Tanay7/Benchmarks/docs/13_Web_UI_Reference.md

# 13 - Ground Station Web UI Reference

This is the operator's reference for the DSS-Q1 web dashboard: the page the ground data
system (GDS) serves on the Arduino VENTUNO Q for the VGQ-1 mission. It explains every tab,
every panel and every number on it: what the number means, which snapshot key carries it,
where it comes from (a radio reading, a telemetry field, a counter or a formula), how often
it changes, what values to expect from this hardware, and what to do when a value looks
wrong.

How to use this document:

* New to the dashboard: read [section 1](#1-how-the-dashboard-works) (where the numbers come
  from, the badges, the number formats and the statistics), then
  [section 2](#2-header-bar-and-beacon-banner) (the header bar), then the tab you need.
* Running a range test: follow [section 17](#17-reading-the-receiver-tab-during-a-range-test).
* Something is red or yellow: [section 15](#15-alarm-logic) lists every alarm reason, and
  [14_Troubleshooting_and_Event_Response.md](14_Troubleshooting_and_Event_Response.md) gives
  the cause and the operator response for every event and alarm.
* Connecting a monitoring system: [section 16](#16-machine-interfaces-metrics-and-the-json-api).

Related documents: [02_Link_Budget_and_RF_Analysis.md](02_Link_Budget_and_RF_Analysis.md)
(sensitivities, link budgets, range), [04_Space_Data_Link_ICD.md](04_Space_Data_Link_ICD.md)
(frames, packets, SDLS, COP-1, CFDP), [05_Telemetry_and_Command_Dictionary.md](05_Telemetry_and_Command_Dictionary.md)
(every packet field and command, generated from the dictionary),
[06_Displays.md](06_Displays.md) (station lamps, buzzer, CardKB console, spacecraft LED
matrix), [07_Operations_Procedures.md](07_Operations_Procedures.md),
[08_Verification_and_Test.md](08_Verification_and_Test.md) (the T-RF-xx tests named below),
[15_Configuration_Reference.md](15_Configuration_Reference.md) (every `station.toml` key),
[17_Security_Model.md](17_Security_Model.md), [18_Data_Products.md](18_Data_Products.md)
(archive, `rx_stats`, CSV export, TDM, XTCE), [19_Glossary.md](19_Glossary.md).

**Where the facts come from.** Every key, formula, threshold and label below was checked
against the final code:
[gds.py](../dssq-groundstation/python/dssq/gds.py) (`GroundStation.snapshot()`,
`science_snapshot()`, `panel_status()`, `_compute_alarm()`),
[rxstats.py](../dssq-groundstation/python/dssq/rxstats.py),
[link.py](../dssq-groundstation/python/dssq/link.py),
[linkmgr.py](../dssq-groundstation/python/dssq/linkmgr.py),
[datalog.py](../dssq-groundstation/python/dssq/datalog.py),
[export.py](../dssq-groundstation/python/dssq/export.py),
[web.py](../dssq-groundstation/python/dssq/display/web.py),
[dashboard.html](../dssq-groundstation/python/dssq/display/dashboard.html),
[dictionary.py](../dssq-groundstation/python/dssq/dictionary.py),
[spectral.py](../dssq-groundstation/python/dssq/spectral.py) and
[magcal.py](../dssq-groundstation/python/dssq/magcal.py), plus the flight packet builder
[flight.cpp](../vgq1-spacecraft/sketch/src/fsw/flight.cpp) for the meaning of telemetry
fields. Where an older document disagrees with the code, the code wins.

**About the example values.** Unless a section says otherwise, the example numbers were
produced by the GDS running against its built-in software spacecraft
(`python -m dssq.gds --sim`, and the same `GroundStation` with the simulator on a virtual
clock): an E22-400T33D link at air-rate code 2 (2.4 kbit/s) and an SX126x link at LoRa
profile 1 (SF12, 62.5 kHz), with a configured distance of 2 km. They show how the numbers
relate to each other; they are not hardware measurements, and a rerun gives somewhat
different numbers (the simulated channel fades and loses frames at random). Where a later
code change altered a value (station identification, RF `tx_duty`, `last_airtime`,
`cltu_bad`), the text says so and quotes a rerun with the final code. The simulator's RF channel is
synthetic: the RSSI hovers around -112 dBm (E22) or -125 dBm (SX126x) and the noise floor
around -118 dBm whatever distance is configured, which is why its "excess loss" comes out
near 67 dB. On real hardware every value marked "VERIFY on hardware" still needs the test
named in [08_Verification_and_Test.md](08_Verification_and_Test.md).

**Screenshots** in [img/](img/) were taken from the simulator (E22 at air-rate code 7,
62.5 kbit/s, with a demonstration command load). A few panels showed paths of the test
machine; those were replaced with neutral placeholders such as `<archive>/files`.

**Drift protection.** [tests/test_docs.py](../tests/test_docs.py) builds real snapshots
(GDS plus simulator, E22 and SX126x) and fails when a snapshot key is missing from this
document, or when a key path written here does not exist in the snapshot.

## Contents

1. [How the dashboard works](#1-how-the-dashboard-works)
2. [Header bar and beacon banner](#2-header-bar-and-beacon-banner)
3. [OVERVIEW tab](#3-overview-tab)
4. [RECEIVER tab](#4-receiver-tab)
5. [LINK & SECURITY tab](#5-link--security-tab)
6. [FRAMES & PACKETS tab](#6-frames--packets-tab)
7. [SPACECRAFT tab](#7-spacecraft-tab)
8. [SPECTROMETER tab](#8-spectrometer-tab)
9. [SCIENCE tab](#9-science-tab)
10. [MAGCAL tab](#10-magcal-tab)
11. [SEQUENCES tab](#11-sequences-tab)
12. [FILES tab](#12-files-tab)
13. [COMMANDING tab](#13-commanding-tab)
14. [Health, events and logs](#14-health-events-and-logs)
15. [Alarm logic](#15-alarm-logic)
16. [Machine interfaces: /metrics and the JSON API](#16-machine-interfaces-metrics-and-the-json-api)
17. [Reading the RECEIVER tab during a range test](#17-reading-the-receiver-tab-during-a-range-test)
18. [Snapshot key index](#18-snapshot-key-index)

---

## 1 How the dashboard works

### 1.1 The path of a number

In plain words: the station radio hands every received packet to the GDS, together with its
signal strength (and, for the SX126x, its signal-to-noise ratio and frequency error). The
GDS finds the frame in it, repairs bit errors with the Reed-Solomon code, checks the frame,
opens the encryption, takes the telemetry packets out, decodes them into named values and
updates its statistics. All of that lives in one state object inside the GDS. Once a second
the web page asks for a copy of that state (the **snapshot**) and redraws the tab you are
looking at. The page never computes link quantities itself: it formats what the GDS sends.

```mermaid
flowchart LR
  RAD["Station radio<br/>E22 (UART) or SX126x (SPI)"] -->|"octets + RSSI octet, or<br/>packet + RSSI / SNR / freq. error"| RUN["GDS radio thread<br/>dssq.gds.Runner"]
  RUN --> DEC["frame sync, RS(255,223),<br/>FECF, SDLS, packets, decom"]
  DEC --> RXS["receiver statistics<br/>rxstats.ReceiverStats"]
  DEC --> TLM["telemetry, limits, events,<br/>COP-1, CFDP, TDM"]
  RXS --> SNAP["GroundStation.snapshot()"]
  TLM --> SNAP
  SNAP -->|"GET /api/state (1 Hz)"| PAGE["dashboard.html"]
  SNAP -->|"GET /metrics"| PROM["Prometheus scraper"]
  SPEC["SpectralState"] -->|"GET /api/science"| PAGE
  SNAP -->|"1 Hz rx_stats row"| ARC["archive gds.sqlite"]
```

The GDS main loop (`Runner.step()` in [gds.py](../dssq-groundstation/python/dssq/gds.py))
runs ten stages in order: register, radio_read, ingest, packets, outbox, jobs, afc, tdm,
housekeeping, console. Each stage is an error boundary: an unexpected failure is counted in
`health.stage_errors`, logged at most once a minute and the loop carries on
([section 14](#14-health-events-and-logs)).

Every number is one of four kinds, and the page says which:

| Kind | Meaning | Example |
|---|---|---|
| measured | read from the radio, the decoder, a counter or a telemetry field | packet RSSI, RS symbols corrected, HK `bus_temp` |
| derived ("est.") | computed from measurements with a stated assumption | SNR est. = RSSI - noise, link margin est., C/N0 est. |
| computed / datasheet / estimated | from a formula or a datasheet, no measurement | free-space path loss, receiver sensitivity |
| configured | typed into `station.toml` | antenna gains, line losses, distance |

A value the GDS does not have is sent as JSON `null` and shown as **—**. Nothing is ever
invented to fill a gap.

### 1.2 Opening the dashboard

| Item | Fact | Source |
|---|---|---|
| URL | `http://<board address>:8080/` | [app.yaml](../dssq-groundstation/app.yaml) `ports: [8080]`; host mode: `[gds] http_host` / `http_port` |
| Bind address | the App's rules (App Lab, and host mode with `python -m dssq.gds --app-data <App>/data`): all interfaces (`0.0.0.0`, override with `DSSQ_HTTP_HOST`); a stand-alone `--config` file: `[gds] http_host` (default `127.0.0.1`) | `resolve_app_paths()` in [config.py](../dssq-groundstation/python/dssq/config.py), `station.toml` |
| Reading | anyone who can reach the port can read every tab | [web.py](../dssq-groundstation/python/dssq/display/web.py) |
| Commanding | every POST needs the `X-DSSQ-Token` header equal to `[gds] http_token`; with the App's rules an empty token is read from, or created once in, `<App>/data/http_token` (mode 0600). A LAN-bound server without a token refuses every POST: the page is read-only | web.py `_check_token` |
| Token entry | the **TOKEN** button in the header (or the prompt after the first refused POST) keeps the token for this browser session only (`sessionStorage`); "TOKEN ✓" means one is set | dashboard.html `setToken` |
| Second operator | with `[commanding] require_two_person_for_hazardous = true`, a hazardous command also needs **2nd-OP AUTH**; with `[commanding] auth_token` set, AUTH also needs the `X-DSSQ-Auth` secret (asked every time, never stored) | gds.py `confirm`, web.py `_check_auth` |
| DNS names | a LAN server answers only IP literals, single-label names, `<name>.local` and `[gds] http_allowed_hosts` (DNS-rebinding guard) | web.py `host_allowed` |

Security details (CSP, request limits, CSRF and DNS-rebinding defences) are in
[17_Security_Model.md](17_Security_Model.md).

### 1.3 How often things change

**What the page polls** (dashboard.html):

| Request | When | Used by |
|---|---|---|
| `GET /api/state` | every 1 s (the next poll starts 1 s after the previous answer; one request at a time) | every tab and the header |
| `GET /api/science` | every 1 s while SPECTROMETER or SCIENCE is visible, every 10 s otherwise | SPECTROMETER, SCIENCE (boom radii) |
| `GET /api/files`, `/api/tdm`, `/api/exports` | when the FILES tab is shown and the lists are older than 5 s | FILES |
| `GET /api/dictionary` | once at start (retried every 5 s until it loads) | enumeration names, command help, builders |

The header shows "GDS LINK DOWN (n s)" in red when no `/api/state` answer arrived for more
than 5 s.

**What drives each value** (the source, not the page):

| Driver | Values | Rate |
|---|---|---|
| every received radio unit (E22 CADU, SX126x packet, also ones that fail to decode) | packet RSSI, SX126x SNR and frequency error, histograms, CRC counters | once per frame period |
| every frame that passes RS and the frame check (FECF) | frame counters, FER, inter-arrival time, the 300-frame chart series | once per frame period |
| a noise-floor reading | noise floor, SNR est. | at most once per `[radio] noise_poll_s` (default 20 s), requested after a received frame when no command is waiting to go up |
| GDS housekeeping | LOS detection, alarm, data-logger row, AFC timers | 1 Hz |
| link manager | its recommendation | every `[linkmgr] period_s` (default 60 s) |
| spacecraft telemetry packets | everything decoded from HK, RF, MAG, ... | the flight cadence below |

The spacecraft sends one frame per **frame period**. The flight software sets it
(`frame_period_ms()` in [datalink.cpp](../vgq1-spacecraft/sketch/src/fsw/datalink.cpp)) to
the largest of: busy time x mode factor (BOOT and SAFE 4.0, CRUISE 2.5, ENCOUNTER and TEST
2.0), busy time / 0.5 (the 50 % transmitter duty limit), 1.5 s, and the FPERIOD command
value; it doubles while the PA over-temperature flag is set. The busy time per frame is
UART transfer plus estimated air time for the E22 and the exact LoRa air time for the
SX126x (`link.busy_s()`):

| Radio and rate | Busy time per frame | Frame period SAFE / CRUISE / ENCOUNTER, TEST |
|---|---|---|
| E22 code 0-2 (2.4 kbit/s) | 1.267 s (245 ms UART + 1022 ms air) | 5.07 / 3.17 / 2.53 s |
| E22 code 3 (4.8 kbit/s) | 0.756 s | 3.02 / 1.89 / 1.51 s |
| E22 code 4 (9.6 kbit/s) | 0.500 s | 2.00 / 1.50 / 1.50 s |
| E22 code 5-7 (19.2-62.5 kbit/s) | 0.372 / 0.308 / 0.284 s | 1.50 s (floor) |
| SX126x profile 0 (SF12, 31.25 kHz) | 34.636 s | 138.5 / 86.6 / 69.3 s |
| SX126x profile 1 (SF12, 62.5 kHz) | 17.318 s | 69.3 / 43.3 / 34.6 s |
| SX126x profile 2 (SF12, 125 kHz) | 8.659 s | 34.6 / 21.6 / 17.3 s |
| SX126x profile 3 (SF11, 125 kHz) | 4.740 s | 19.0 / 11.9 / 9.5 s |
| SX126x profile 4 (SF10, 125 kHz) | 2.165 s | 8.7 / 5.4 / 4.3 s |
| SX126x profile 5 (SF9, 125 kHz) | 1.185 s | 4.7 / 3.0 / 2.4 s |
| SX126x profile 6 (SF8, 125 kHz) | 0.665 s | 2.7 / 1.7 / 1.5 s |
| SX126x profile 7 (SF7, 125 kHz) | 0.373 s | 1.5 s (floor) |

Telemetry packets are generated at the flight's per-mode cadence (`kModeCadence`, seconds,
0 = off) and stretched on board when the link cannot carry them; `PKTRATE` overrides one
packet type:

| Mode | HK | RF | TIMECORR | MAG | ATT | SPEC | ENV |
|---|---|---|---|---|---|---|---|
| BOOT | 10 | 10 | off | off | off | off | off |
| SAFE | 30 | 60 | 300 | off | off | off | off |
| CRUISE | 60 | 60 | 300 | 30 | 60 | 300 | 120 |
| ENCOUNTER | 20 | 30 | 120 | 4 | 8 | 30 | 30 |
| TEST | 10 | 10 | 60 | 4 | 8 | 30 | 30 |

So a value decoded from HK changes at most every 10-60 s, while the RECEIVER values move
with every frame.

### 1.4 Measured, estimated, computed: the badges and labels

Small coloured badges and words in labels tell you how far to trust a number.

| Badge or label | Colour | Meaning | Where it appears |
|---|---|---|---|
| **measured** | green | read from a radio, decoder or counter; for a sensitivity: a value from test T-RF-03 in `[radio.sensitivity_measured]` | link budget "measured" column; sensitivity source |
| **datasheet** | blue | taken from a manufacturer datasheet | sensitivity (T33D -128 dBm, T37S -126 dBm at 2.4 kbit/s; SX126x where Semtech Table 3-8 lists the profile); T37S TX power (37 dBm on every code) |
| **computed** | blue in the link budget, amber as a sensitivity source | a formula on configured or datasheet inputs, no measurement: free-space loss, thermal noise, the SX126x sensitivity -174 + 10 log10(BW) + NF + SNRmin | link budget, sensitivity source, LoRa air time |
| **estimated** | amber | an extrapolation from a datasheet value: E22 sensitivity above 2.4 kbit/s, E22 air time, SX126x sensitivity without boosted gain | sensitivity source, air-time source |
| **configured** | grey | typed into `station.toml` | antenna gains, line losses, distance |
| **est.** | amber | a derived quantity resting on an assumption | EIRP, excess loss, link margin, range at sensitivity, SNR est. |
| **VERIFY T-RF-07** | amber | the transmitter power for this code has not been measured yet (E22-400T33D codes 1-3 and every SX126x code; the T37S is "datasheet") | link budget, radio configuration |
| "est." in a label | - | the same as the badge: "SNR est. (RSSI - noise)", "N0 est." | RECEIVER |
| "approximate (18-band)" | - | spectrometer radiometry and colorimetry built from 18 filter bands | SPECTROMETER |
| "heuristic" | - | rule-based judgement (light-source class, fluorescence, burst transients) | SPECTROMETER |
| "proxy" | - | an index evaluated on the nearest available bands (WBI, PRI) | SPECTROMETER |
| "informational" | - | shown for insight, not for decisions (die-temperature drift) | SPECTROMETER |
| **MISMATCH** | red | the spacecraft reports a different radio model, or the station SX126x sketch was built for another chip / TCXO | RECEIVER radio configuration, SX126x MCU |

Telemetry limits colour the value cell: yellow background for YELLOW, red for RED
([section 7.2](#72-limits-and-how-they-are-checked)). Text colours: green = good, amber =
needs attention, red = bad, grey = not applicable.

### 1.5 Display conventions

The page formats numbers with a few helpers in dashboard.html; the table says which one
each kind of value uses.

| Kind of value | Shown as | Example | Rule (dashboard.html) |
|---|---|---|---|
| measured received power and what is derived from it (RSSI, noise floor, SNR est., margin est., signal power est., N0, C/N0, Eb/N0, measured path loss): single readings and window statistics alike | at the readings' resolution, never finer (D-70): whole dB with the E22; with the SX126x RSSI in 0.5 dB steps, the rest in 0.1 dB; means are shown without "± SEM" | -39 dBm (E22), -113.5 dBm (SX126x) | `fres(v, kind)` |
| SX126x measured SNR (SnrPkt/4) | 2 decimals (0.25 dB steps) | 6.25 dB | `fx(v, 2)` |
| computed link-budget figures (the "design" column) | 4 decimals | -110.4321 dBm | `fx(v, 4)` |
| frequencies, frequency errors, Doppler | 1 decimal, Hz | 433125000.0 Hz, 469.0 Hz | `fu(v, 1, "Hz")` |
| frequency in MHz | 6 decimals | 433.125000 MHz | RF now |
| range rate | 3 decimals, m/s | -1161.447 m/s | Doppler panel |
| rates and percentages | 2 decimals | 22.00 bit/s, 79.94 % | `fpct()`, `fx(v, 2)` |
| FER, BER, SER, CER, packet error rate | scientific, 3 significant digits | 4.18e-2 | `fsci()` = `toExponential(2)` |
| spectral values (µW/cm²) | 4 significant digits | 40.07 | `fsig(v, 4)` |
| counts | whole numbers with thousands separators | 81,803 | `fint()` |
| telemetry fields (SPACECRAFT) | the decimals of the field's scale (0.01 -> 2, 0.1 -> 1, 0.001 -> 3); integers as integers | 32.42 degC | `tlmTable()` |
| times | UTC, ISO 8601 to the second | 2027-01-15T08:00:02Z | `iso()` |
| times in logs | time of day, UTC | 20:52:19Z | `tod()` |
| durations | seconds below 1 min, else d h m s | 5.4 s, 20m 28s | `dur()` |
| "ago" | time since the value's timestamp | 1m 9s ago | `ago()` |
| file sizes (CFDP, TDM, exports) | binary units | 4.2 KiB | `size()` |
| archive sizes (data logger) | SI units, as `archive_max_gb` / `archive_min_free_mb` | 13.2 GB | `sizeSI()` |
| one-way light time | µs, ms or s with 3 decimals | 6.671 µs | `owlt()` |
| booleans | yes / no | yes | `fyn()` |
| no value | — | — | null, missing, NaN or infinite |

**Resolution of a single reading** (what one reading can resolve, not its accuracy):

| Reading | Resolution | Source |
|---|---|---|
| E22 packet RSSI and noise register | 1 dB | E22-400T33D manual v1.05 REG1 bit 5 (registers 0x00 noise, 0x01 last packet) and REG3 bit 7 (the appended RSSI octet): one whole octet, dBm = -(256 - octet); the manual states no finer step and no accuracy (V-18). The SX1262's own 0.5 dB register is not passed through. `rxstats.E22_RSSI_RESOLUTION_DB` |
| SX126x packet RSSI | 0.5 dB | SX1261/2 datasheet GetPacketStatus: RssiPkt / 2; `rxstats.SX126X_RSSI_RESOLUTION_DB` |
| SX126x packet SNR | 0.25 dB | SnrPkt / 4 |
| SX126x noise floor | 0.1 dB | median of 8 instantaneous RSSI samples, sent in 0.1 dBm (`rf_noise`) |
| SX126x frequency error | 1 Hz (whole Hz from the station MCU) | `rf_rx` freq_err_hz |

The absolute accuracy of every RSSI and noise value is set by the station calibration
`[radio] rssi_cal_offset_db`, which test T-RF-02 determines
([08_Verification_and_Test.md](08_Verification_and_Test.md)). Until that test is done,
treat absolute dBm values as uncalibrated (VERIFY on hardware); differences between two
readings of the same radio are still meaningful.

### 1.6 The statistics windows explained

The RECEIVER tab keeps eight measured quantities in three windows and summarises each
window with eleven statistics (`rx.windows`, computed by `rxstats.Window.stats()`).

**The windows.**

| Window | Key | What it holds | Cap |
|---|---|---|---|
| 1 min | `rx.windows.1m` | samples of the last 60 s | 20,000 samples |
| 10 min | `rx.windows.10m` | samples of the last 600 s | 20,000 samples |
| pass | `rx.windows.pass` | samples since the current pass began (AOS); emptied at every AOS except for the AOS frame's own samples | 20,000 samples; then the oldest are dropped and the window reports `truncated` = true ("pass (truncated)") |

Old samples leave the 1 min and 10 min windows when a new sample arrives and whenever the
snapshot is built, so a window empties itself during LOS. The inter-pass gap is never
counted as an inter-arrival time.

**The statistics** (n samples x1 ... xn, sorted s1 <= ... <= sn):

| Column | Key | Formula | What it tells you |
|---|---|---|---|
| n | `n` | number of samples | how much the other columns are worth; with n = 1 there is no spread |
| mean | `mean` | (1/n) Σ xi | the typical level |
| ± SEM | `sem` | s / √n, with s = √(Σ (xi - mean)² / (n - 1)) the sample standard deviation | how well the mean is known (needs n >= 2) |
| σ | `std` | √(Σ (xi - mean)² / n), the population standard deviation | how much single readings scatter (fading, noise) |
| min | `min` | s1 | the worst (lowest) reading |
| p10 | `p10` | the 10th percentile, linear interpolation at k = 0.10 (n - 1) between neighbouring sorted samples | the level the signal stayed above 90 % of the time |
| p50 | `p50` | the median, k = 0.50 (n - 1) | the middle reading, robust to outliers |
| p90 | `p90` | the 90th percentile, k = 0.90 (n - 1) | the level exceeded only 10 % of the time |
| max | `max` | sn | the best (highest) reading |
| last | `last` | xn in arrival order | the newest reading |
| fade p90-p10 | `fade_depth` | p90 - p10 | the depth of fading: how far the signal swings |

**Worked example.** Five RSSI readings -112, -110, -113, -111, -114 dBm (computed with the
GDS's own `Window` class): n = 5, mean = -112.0000; deviations 0, +2, -1, +1, -2, so
Σ d² = 10; σ = √(10/5) = 1.4142 dB; s = √(10/4) = 1.5811 dB; SEM = 1.5811 / √5 = 0.7071 dB;
sorted -114, -113, -112, -111, -110: p10 at k = 0.4 gives -114 + 0.4 x 1 = -113.6000,
p50 = -112.0000, p90 at k = 3.6 gives -111 + 0.6 x 1 = -110.4000; fade depth = 3.2000 dB;
last = -114.0000.

**Why the readings' resolution?** (D-70, on the owner's request after the first bench link.)
The E22 reports received power and its noise register in whole dB, so the page shows no
digit finer than that: a 1-minute mean of -39.2 dBm is shown as -39 dBm, and its SEM, below the
resolution, is not shown at all. The statistics are still computed at full precision: the
snapshot (`rx.windows`), the RECEIVER statistics' source data, the CSV exports and the data
logger keep every digit, for anyone who wants to compare window means more finely. The
absolute accuracy is a separate matter again: it is limited by the calibration offset
(T-RF-02), not by the resolution. The worked example above shows the full-precision values;
the page shows them as -112, 1, 2, 1, -114, -114, -112, -110, -110, 3 and -114 dB(m).

**How to read SEM.** Two means differ significantly when their difference is larger than
about 2√(SEM1² + SEM2²). SEM assumes independent readings; slow fading makes neighbouring
frames correlated, so treat SEM as a lower bound on the uncertainty of the mean. Look at σ
and the fade depth to see how much single readings move.

### 1.7 Snapshot keys and the notation in this document

`/api/state` returns one JSON object (`GroundStation.snapshot()`, schema 3) with 37
top-level keys; `/api/science` returns the spectrometer analytics separately
(`science_snapshot()`). This document writes a value's location as a dotted path from the
root: `rx.rf.rssi_dbm` is `snapshot["rx"]["rf"]["rssi_dbm"]`. Paths that start with
`spectral`, `spectral_history`, `spectral_burst`, `spectral_skymap`, `spectral_library`,
`cfg` or `led_limits` are in `/api/science`. A part in angle brackets is a placeholder for a
name that varies: `vc.<vc>.frames` (one entry per virtual channel), `apids.<packet>.count`,
`tlm.<packet>.values.<field>`, `rx.windows.<window>.<metric>.<stat>`. `[]` after a part
means "each element of this list": `cfdp.transactions[].progress`.

| Top-level key | What it holds | Section |
|---|---|---|
| `schema` | snapshot schema version (3) | [13.7](#137-gds-health-panel) |
| `version` | GDS software version (`dssq.__version__`, 3.0.0) | [13.7](#137-gds-health-panel) |
| `utc` | station time when the snapshot was built (UNIX s) | [2](#2-header-bar-and-beacon-banner) |
| `station` | station name, `[station] name` | [2](#2-header-bar-and-beacon-banner) |
| `spacecraft` | spacecraft name, `[spacecraft] name` | [2](#2-header-bar-and-beacon-banner) |
| `uptime_s` | seconds since the GDS started | [13.7](#137-gds-health-panel) |
| `mode` | GDS run mode: `host`, `applab` or `sim` | [2](#2-header-bar-and-beacon-banner) |
| `alarm` | NONE, YELLOW or RED | [15](#15-alarm-logic) |
| `alarm_reasons` | every reason, RED first | [15](#15-alarm-logic) |
| `alarm_red_count` | how many of `alarm_reasons` are RED | [15](#15-alarm-logic) |
| `beacon` | spacecraft beacon level and history | [2](#2-header-bar-and-beacon-banner), [7.7](#77-beacon) |
| `rx` | receiver statistics engine (RF, windows, budget, decoder, frames ...) | [4](#4-receiver-tab) |
| `radio` | station radio configuration, model checks, jobs | [4.6](#46-radio-configuration) |
| `link` | framing, SDLS, OID identification, station identification | [5](#5-link--security-tab) |
| `sync` | frame synchronizer state and counters | [4.9](#49-frame-synchronizer) |
| `vc` | per-virtual-channel counters | [6.2](#62-virtual-channels) |
| `apids` | per-APID packet statistics | [6.3](#63-packets-by-apid) |
| `tlm` | latest decoded real-time packet of each type | [7](#7-spacecraft-tab), [9](#9-science-tab) |
| `decoded` | enumerations and bit masks of HK / RF / MAG as names | [7](#7-spacecraft-tab) |
| `time` | SCLK correlation | [5.8](#58-time-correlation) |
| `cop` | COP-1 FOP-1 sender state and recent commands | [5.5](#55-cop-1-fop) |
| `cfdp` | CFDP class-1 receiver and onboard sender state | [12.1](#121-cfdp-transactions) |
| `tdm` | CCSDS Tracking Data Message recorder | [12.4](#124-tracking-data-messages-and-xtce) |
| `sequence` | stored-sequence state, checked file, uplink | [11](#11-sequences-tab) |
| `magcal` | magnetometer calibration collectors and fits | [10](#10-magcal-tab) |
| `health` | GDS stage errors, archive write errors | [14](#14-health-events-and-logs) |
| `logger` | receiver data logger: rows, space, retention | [12.5](#125-receiver-data-logger) |
| `linkmgr` | adaptive link manager | [4.16](#416-link-manager-and-pass-events) |
| `pending_confirm` | commands waiting for CONFIRM / AUTH | [13.2](#132-pending-confirmations) |
| `evrs` | the last 40 spacecraft event reports | [7.10](#710-spacecraft-evrs) |
| `events` | the last 80 ground events | [14](#14-health-events-and-logs) |
| `anomalies` | the last 20 statistical outliers | [7.11](#711-anomaly-detector) |
| `console` | the last 30 console lines | [13.4](#134-console) |
| `station_io` | station I/O MCU (CardKB, annunciators) | [13.8](#138-station-io-panel) |
| `cmd_stages` | names of the CMDVER stages (for the page) | [7.9](#79-other-packets-cmdver-timecorr-rfscan) |
| `cmd_errors` | names of the command error codes | [7.9](#79-other-packets-cmdver-timecorr-rfscan) |
| `cmd_sources` | names of the CMDVER command sources | [7.9](#79-other-packets-cmdver-timecorr-rfscan) |

`/api/science` top-level keys: `spectral`, `spectral_history`, `spectral_burst`,
`spectral_skymap`, `spectral_library`, `cfg` (the `[science]` table) and `led_limits`
([section 8](#8-spectrometer-tab)).

---

## 2 Header bar and beacon banner

The header is visible on every tab. It answers four questions at a glance: do we hear the
spacecraft, is anything wrong, how good is the link, and is the uplink working. It is built
by `renderHeader()` from `/api/state`.

```
+------------------------------------------------------------------------------------------+
| BEACON URGENT since ... (only when the beacon level is 1..3)                               |
+------------------------------------------------------------------------------------------+
| DSS-Q1 GROUND STATION  S/C VGQ-1  [AOS] [LOCK] [ALARM NONE]  MODE CRUISE  UTC ...          |
| RSSI-1m ...  SNR ...  MARGIN ...  FER ...  FRAMES ...  SCLK ...  COP-1 ...  SDLS TM ...    |
| FRAMING ...                                              GDS 3.0.0 applab   [TOKEN]       |
+------------------------------------------------------------------------------------------+
| OVERVIEW  RECEIVER  LINK & SECURITY  FRAMES & PACKETS  SPACECRAFT  ...  COMMANDING         |
| [pending confirmation strip: #id text, CONFIRM, 2nd-OP AUTH, CANCEL]                       |
+------------------------------------------------------------------------------------------+
```

| Shown as | Key | Format and colours | Meaning; what to do |
|---|---|---|---|
| DSS-Q1 GROUND STATION | `station` | text + " GROUND STATION" | station name from `[station] name` |
| S/C VGQ-1 | `spacecraft` | text | spacecraft name from `[spacecraft] name` |
| AOS / LOS pill | `rx.state.los`, `rx.state.hibernating` | green **AOS** (tooltip: pass duration); red **LOS** (tooltip: time since the last frame); amber **LOS (hibernating)** | AOS = frames are arriving. LOS = no valid frame for longer than the LOS timeout ([4.18](#418-receiver-state)). LOS while the spacecraft hibernates is expected and shown amber. Unexpected LOS: [section 17](#17-reading-the-receiver-tab-during-a-range-test) and docs/14 "LOS" |
| SYNC pill | `sync.state` | green LOCK or PACKET, amber FLYWHEEL, red SEARCH | frame synchronizer state ([4.9](#49-frame-synchronizer)); PACKET is the SX126x (one CADU per LoRa packet, no byte-stream search) |
| ALARM pill | `alarm`, tooltip `alarm_reasons` | green NONE, amber YELLOW, red RED | the station alarm ([section 15](#15-alarm-logic)); hover to read every reason |
| MODE | `decoded.mode` | text | the **spacecraft** flight-software mode from HK `fsw_mode`: BOOT, SAFE, CRUISE, ENCOUNTER, TEST. (The GDS run mode is at the right end.) |
| UTC | `utc` | ISO 8601 | the station clock when the snapshot was built; check it against a reference clock: SCET, TDM and latency depend on it (NTP) |
| RSSI | `rx.rf.rssi_dbm` | "-111 dBm", at the readings' resolution (1.5); **—** during LOS | the newest frame's calibrated packet RSSI as the radio reported it (D-70; the window means are on the RECEIVER tab) ([1.6](#16-the-statistics-windows-explained)) |
| SNR | `rx.rf.packet.snr_db`, else `rx.rf.snr_est_db` | SX126x: measured SNR, 2 decimals, "dB"; E22: "dB est." (RSSI - noise), whole dB; **—** during LOS | the newest frame's signal-to-noise ratio; during LOS the last value is history, not the link, so it is hidden here (the RECEIVER tab keeps it with its time) |
| MARGIN | `rx.rf.margin_est_db` | dB at the readings' resolution (1.5); **—** during LOS | newest RSSI minus the receiver sensitivity ([4.2](#42-rf-now)) |
| FER | `rx.frames.fer` | scientific | frame error rate since the GDS started ([4.11](#411-frames)) |
| FRAMES | `rx.frames.ok`, `rx.frames.lost` | "344 / lost 15" | frames received and frames missing (master-channel counter gaps) |
| SCLK | `time.partition`, `time.sclk_estimate_s` | "1/1224" | spacecraft clock: partition (boot counter) / estimated SCLK seconds now ([5.8](#58-time-correlation)) |
| COP-1 | `cop.vs`, `cop.nr`, `cop.lockout`, `cop.uplink_blocked`, `cop.suspended`, `cop.outstanding` | "V(S)=4 N(R)=4 OK out=1" | uplink protocol state: next frame number to send, the spacecraft's next expected number, and LOCKOUT / BLOCKED / SUSPENDED / OK ([5.5](#55-cop-1-fop)) |
| SDLS TM | `link.sdls.spacecraft_tm_state`, `link.sdls.tm_service` | "PROTECTED (AE)" | downlink security: the spacecraft's TM state from HK and the ground's TM service ([5.2](#52-sdls)) |
| FRAMING | `link.tm_framing_seen` | "TM TM 344 / USLP 0" | format of the last frame, then the count of TM and USLP frames seen |
| GDS 3.0.0 applab | `version`, `mode` | grey; red "GDS LINK DOWN (n s)" when no answer for > 5 s; amber "connecting…" before the first answer | the GDS software version and run mode (`host`, `applab`, `sim`). LINK DOWN: the browser cannot reach the GDS (network, App stopped) |
| TOKEN | (browser) | "TOKEN" or "TOKEN ✓" | the commanding token kept for this browser session ([1.2](#12-opening-the-dashboard)) |
| display error line | (browser) | red text under the tabs | a rendering failure in the page ("data shown may be incomplete"); reload the page and report it |

**Beacon banner** (`beacon`): a full-width band above the header when the spacecraft's
beacon level (HK `beacon_level`, [7.7](#77-beacon)) is above NOMINAL: blue for INTERESTING,
amber for IMPORTANT, red and flashing for URGENT. Text: "BEACON <`beacon.name`> since
<`beacon.since`>", then "SPACECRAFT HIBERNATING" when `beacon.hibernating` is true, then
"last beacon HK <time since `beacon.t`> ago". The level is the spacecraft's own judgement
of how urgently it needs attention (Deep Space 1 Beacon Monitor concept, `BeaconMonitor`
in [autonomy.cpp](../vgq1-spacecraft/sketch/src/fsw/autonomy.cpp)); on board it only rises
until the spacecraft accepts a command. That ground contact acknowledges the events (EVRs,
lost sensors, brownout, SSR drops, completed sequences) and re-evaluates the standing
conditions: a SAFE entered by fault protection or a sequence stopped by fault protection
keeps the level URGENT until it is resolved (for example by `MODE CRUISE`). What to do: open
the SPACECRAFT tab, read the EVRs and the fault-protection flags, act on them, then send a
command (NOOP is enough when nothing else is needed) to acknowledge.

**Pending-confirmation strip** (`pending_confirm`): one line per command waiting for
confirmation, on every tab ([13.2](#132-pending-confirmations)).

---

## 3 OVERVIEW tab

**What it is for.** The first tab you look at: one row of tiles summarising the link, the
spacecraft and the uplink, two charts of the signal, the spacecraft summary, the alarm
reasons, the newest events and the status of the newest commands. If everything here is
green, the other tabs can wait.

```
+--------+--------+--------+--------+--------+--------+--------+--------+
| Signal | RSSI   | SNR    | Margin | Frames | Thru-  | RS     | S/C    |   (tiles wrap
| AOS    | 1-min  | est.   | est.   |        | put    | decoder| mode   |    to the width
+--------+--------+--------+--------+--------+--------+--------+--------+    of the window)
| Bus    | SDLS   | Uplink | CFDP   |
| temp   | TM     |        | onboard|
+------------------------+------------------------+------------------------+
| Received power chart   | Signal-to-noise chart  | Spacecraft summary     |
+------------------------+------------------------+------------------------+
| Alarm reasons          | Latest events          | Command status         |
+------------------------+------------------------+------------------------+
```

OVERVIEW tab

### 3.1 Tiles

| Tile | Big value (key) | Small line | Colour | Meaning; if abnormal |
|---|---|---|---|---|
| Signal | AOS / LOS (`rx.state.los`) | "pass 4m 11s" (`rx.state.pass_duration_s`) or "since frame 2m 5s" (`rx.state.since_last_frame_s`) | green AOS, red LOS | are frames arriving; LOS: [17](#17-reading-the-receiver-tab-during-a-range-test) step 1 |
| RSSI | `rx.rf.rssi_dbm`, at the readings' resolution; **—** during LOS | "dBm, newest frame"; tooltip: its resolution | - | signal strength, averaged ([4.2](#42-rf-now)) |
| SNR est. | `rx.rf.snr_est_db`, at the readings' resolution; **—** during LOS | "dB, newest frame", plus "meas x.xx" with an SX126x (`rx.rf.packet.snr_db`) | - | RSSI minus noise floor, averaged |
| Margin est. | `rx.rf.margin_est_db`, at the readings' resolution | "dB vs <sensitivity> dBm (<source>)"; during LOS "LOS · last x dB, t ago" | red < 3 dB, amber 3-6 dB, green >= 6 dB | how far above the decode threshold the newest frame was; below 3 dB frames start to drop |
| Frames | `rx.frames.ok` | "lost n · FER x" | - | frames received, lost, frame error rate |
| Throughput | `rx.frames.info_rate_bps`, 1 dp | "bit/s info · n frames/min" | - | useful telemetry bits per second over the last 60 s ([4.11](#411-frames)) |
| RS decoder | `rx.decoder.symbols_corrected` | "sym corrected · uncorrectable n" | amber when any codeblock was uncorrectable | how hard the error correction works ([4.10](#410-decoder)) |
| S/C mode | `decoded.mode` | "beacon <name> · FDIR <number of active flags>" | - | spacecraft mode, beacon level and active fault-protection flags |
| Bus temperature | `tlm.HK.values.bus_temp`, 2 dp | "°C (Nicla Sense ME BME688)" | amber on a YELLOW or RED limit | spacecraft bus temperature ([7.3](#73-housekeeping-hk-all-43-fields)) |
| SDLS TM | `link.sdls.spacecraft_tm_state` | "frames ok n · fail n" (`link.sdls.tm_frames_ok`, `link.sdls.tm_auth_fail`) | - | downlink security state ([5.2](#52-sdls)) |
| Uplink | "n out / n q" (`cop.outstanding`, `cop.queued`) | "V(S) n · FOP OK / LOCKOUT / BLOCKED" | red on LOCKOUT or BLOCKED | commands in flight and waiting ([5.5](#55-cop-1-fop)) |
| CFDP onboard | `cfdp.onboard.state_name` | "seq n · progress %" | - | the spacecraft's file sender ([12.1](#121-cfdp-transactions)) |

### 3.2 Charts

| Chart | Series (keys) | Window | Notes |
|---|---|---|---|
| Received power | RSSI (`rx.series.rssi`), noise floor (`rx.series.noise`), against `rx.series.t` | the last 300 frames | dBm; a frame's RSSI is drawn only when it belongs to that frame; the noise line holds the latest reading |
| Signal-to-noise | SNR est. (`rx.series.snr_est`), SNR measured (`rx.series.snr_meas`, SX126x), margin est. (`rx.series.margin`) | the last 300 frames | dB; dashed red line at 0 dB. Hover any chart to read the values of one frame |

### 3.3 Spacecraft summary

| Row | Keys | Meaning |
|---|---|---|
| Mode / uptime | `decoded.mode`, `tlm.HK.values.uptime_s` | flight mode and time since the MCU booted |
| Last reset cause | `decoded.reset_cause` | POWER-ON, PIN, SOFTWARE, WATCHDOG, BROWNOUT, UNKNOWN (BROWNOUT raises a YELLOW alarm) |
| SCLK partition / estimate | `tlm.HK.values.sclk_partition`, `time.sclk_estimate_s` | boot counter and estimated SCLK now |
| FDIR active | `decoded.fdir` | names of the set fault-protection flags; amber when any |
| Sensors missing | `decoded.sensors_missing` | instruments the spacecraft reports as not working; amber when any |
| Radio (spacecraft) | `decoded.radio_model`, `decoded.framing`, `decoded.rate_label` | from the RF packet |
| Radio fault | `decoded.radio_fault` | last radio fault; red when not NONE |
| SSR fill / dropped | `tlm.HK.values.ssr_fill`, `tlm.HK.values.ssr_dropped` | solid-state recorder |
| Commands accepted / rejected | `tlm.HK.values.cmd_accepted`, `tlm.HK.values.cmd_rejected` | onboard command counters |
| Last HK / RF / MAG / SPEC | `tlm.<packet>.ert` | how long ago each packet type last arrived |
| Sequence / MAGCAL | `decoded.seq_state`, `decoded.magcal` | stored-sequence state; onboard calibration active outboard / inboard |

### 3.4 Alarm reasons, latest events, command status

* **Alarm reasons** (`alarm_reasons`, `alarm_red_count`): RED reasons first in red, then
  YELLOW in amber; "none" when the alarm is NONE ([section 15](#15-alarm-logic)).
* **Latest events** (`events`): the newest 16 ground events, newest first, coloured by
  level (WARN amber, ERROR red) ([section 14](#14-health-events-and-logs)).
* **Command status** (`cop.recent`): the newest 8 commands: number, text, state and
  radiate-to-done time ([13.3](#133-command-history)). States go QUEUED -> RADIATED ->
  ACCEPTED (the CLCW shows the spacecraft's FARM took the frame) -> EXECUTED or FAILED
  (CMDVER); TIMEOUT and SUSPENDED are failures of the uplink protocol.

---

## 4 RECEIVER tab

### 4.1 What the tab is for

The RECEIVER tab is the station's receiver laboratory. It shows every quantity the ground
radio measures (signal strength, noise, signal-to-noise ratio, frequency error), what the
GDS derives from them (margin, C/N0, Eb/N0, Doppler), how hard the decoder works (Reed-Solomon
corrections, lost frames) and how the measured link compares with the free-space link
budget. Look at it when you set up the station, during every range test
([section 17](#17-reading-the-receiver-tab-during-a-range-test)), when the margin tile turns
amber or red, and when frames go missing.

Two radio families behave differently here:

* **E22 UART modules** (E22-400T33D default, E22-400T37S): the module reports a whole-dB
  RSSI per packet and, on request, a whole-dB ambient-noise register. It does not report
  SNR or frequency error, so SNR, C/N0 and Eb/N0 are **estimates** from RSSI minus noise,
  and every frequency-error, AFC and Doppler field shows "—".
* **SX126x** (SPI, RadioLib; reference module E22-400M33S): the station MCU reports for
  every packet the RSSI (0.5 dB steps), the measured SNR (0.25 dB) and the LoRa
  frequency-error estimate, and measures the noise floor as the median of 8 instantaneous
  RSSI samples. SNR, C/N0 and Eb/N0 are then based on the **measured** SNR, and the AFC,
  frequency-offset state and Doppler are live.

Layout (three columns on a wide screen; panels reflow on a narrow one):

```
+-----------------------------+-----------------------------+
| RF now (every rx.rf scalar) | Link budget (design vs       |
|                             | measured, downlink + uplink) |
+-----------------------------+-----------------------------+-----------------------------+
| Receiver statistics: 8 metrics x 3 windows (1 min, 10 min, pass) x 11 statistics         |
+-----------------------------+-----------------------------+-----------------------------+
| Packet RSSI and noise chart | SNR and margin chart        | Frequency error chart       |
| Frequency-error gauge       | Radio configuration         | AFC (+ last 20 AFC events)  |
| Doppler and range rate      | Frame synchronizer          | Decoder                     |
| Frames (+ VC / format)      | Packets per APID            | SX126x station MCU          |
| Serial / radio link         | Two-way link                | Link manager & pass events  |
| RSSI distribution           | SNR distribution            | Frequency-error distribution|
| RS corrections / codeblock  | ASM bit errors / frame      | RF survey                   |
+-----------------------------+-----------------------------+-----------------------------+
```

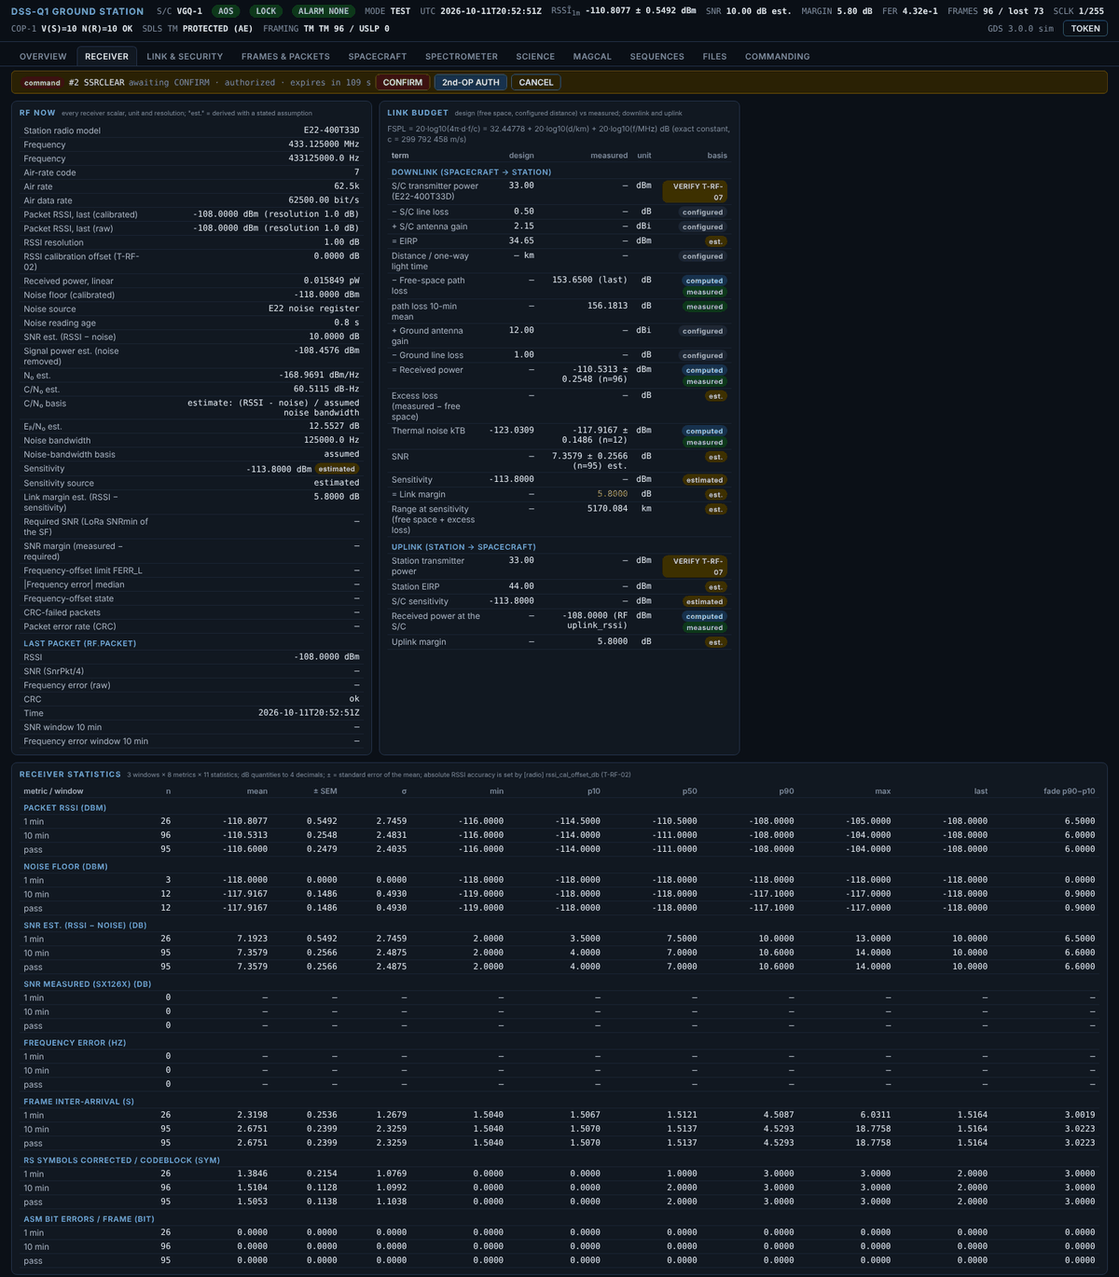
[picture p1: docs/img/ui_receiver_1.png]
RECEIVER tab: RF now, link budget, statistics


RECEIVER tab: charts, radio configuration, decoder

RECEIVER tab: frames, two-way link, histograms, RF survey

### 4.2 RF now

The "RF now" panel lists every scalar of `rx.rf` (built by `ReceiverStats.snapshot()` in
[rxstats.py](../dssq-groundstation/python/dssq/rxstats.py)), then the last packet and the
10-minute SNR and frequency-error summaries. The values are those of the **newest
reception**; their statistics over time are in [4.3](#43-receiver-statistics). Each card
below gives: what the panel shows, the snapshot key, unit and display, the exact source,
the formula, how often it changes, what to expect from this hardware, how to read it, what
to do when it is abnormal, related values and a worked example.

#### Station radio model, frequency and air rate

| Shown as | Key | Unit, display | Source and formula | Example |
|---|---|---|---|---|
| Station radio model | `rx.rf.model` | text | `[radio] model`; with `model = "auto"` (or absent) the E22 model the spacecraft reports in its RF packet (`radio_model`), E22-400T33D until then | E22-400T33D |
| Frequency | `rx.rf.freq_mhz` | MHz, 6 decimals | f = 410.125 MHz + CH x 1 MHz, CH = `[radio] channel` (0..83; E22 manuals, REG2) | 433.125000 MHz (CH 23) |
| Frequency | `rx.rf.freq_hz` | Hz, 1 decimal | the same in Hz | 433125000.0 Hz |
| Air-rate code | `rx.rf.air_rate_code` | 0..7 | `[radio] air_rate`, changed by LINKRATE: E22 REG0 air-rate code; SX126x LoRa profile | 2 |
| Air rate | `rx.rf.rate_label` | text | E22 "2.4k" ... "62.5k" (codes 0, 1 and 2 are all 2.4 kbit/s); SX126x "SF12 BW62.5 CR4/5" | 2.4k |
| Air data rate | `rx.rf.air_rate_bps` | bit/s, 2 decimals | E22: the nominal air rate; SX126x: Rb = SF x BW / 2^SF x 4 / (4 + CR) (`LoRaProfile.bit_rate_bps`) | 2400.00; SX126x profile 1: 146.48 |

These change only with the configuration (LINKRATE / LINKCHAN, [4.6](#46-radio-configuration)).
If the frequency or rate differs from the spacecraft's (RF packet `channel`,
`air_rate_code`), the two ends cannot hear each other: see the "model / rate mismatch"
checks in [4.6](#46-radio-configuration).

#### Packet RSSI (calibrated and raw)

| | |
|---|---|
| Shown as | "Packet RSSI, last (calibrated)" and "Packet RSSI, last (raw)", each followed by "(resolution x dB)" |
| Keys | `rx.rf.rssi_dbm` (calibrated), `rx.rf.rssi_raw_dbm` (raw); the same value is `rx.rf.packet.rssi_dbm` |
| Unit, display | dBm at the resolution: whole dB (E22), 0.5 dB steps (SX126x) |
| Source | E22: the RSSI octet the module appends to each received packet (REG3 bit 7, `[radio] rssi_byte = true`), dBm = -(256 - octet) (`framesync._emit`). SX126x: RssiPkt / 2 from GetPacketStatus, sent by the station MCU in 0.1 dBm in `rf_rx` |
| Formula | RSSI_cal = RSSI_raw + C, with C = `[radio] rssi_cal_offset_db` (shown below) |
| Updates | every received radio unit, also ones that later fail RS, the frame check or the LoRa CRC |
| This hardware | frames decode down to the receiver sensitivity: E22-400T33D -128 dBm and E22-400T37S -126 dBm at 2.4 kbit/s (datasheet), 3 dB less per doubling of the air rate (estimated); SX126x from -124.0 dBm (SF7, datasheet) to -143.1 dBm (SF12 / 31.25 kHz, computed). See "Sensitivity" below |
| Meaning | the power of the newest packet at the radio's antenna port. One reading jumps with fading by several dB; judge the link by the window means and percentiles ([4.3](#43-receiver-statistics)) |
| If abnormal | far below the link budget's predicted received power: check antenna pointing and polarization, cable and connectors, obstructions (the "Excess loss" row, [4.5](#45-link-budget)); no value at all: nothing is being received (header AOS / SYNC); a sudden step at constant geometry: a changed cable, attenuator or calibration offset. Event and alarm responses: [14_Troubleshooting_and_Event_Response.md](14_Troubleshooting_and_Event_Response.md) |
| Related | noise floor, SNR est., link margin est., RSSI distribution, link budget "= Received power" |
| Example | E22 at 2.4k: raw -113 dBm, offset 0.0 dB, so -113.0000 dBm; SX126x profile 1: -126.0000 dBm |

#### RSSI resolution and calibration offset

| | |
|---|---|
| Shown as | "RSSI resolution" and "RSSI calibration offset (T-RF-02)" |
| Keys | `rx.rf.rssi_resolution_db`, `rx.rf.rssi_cal_offset_db` |
| Unit, display | dB; resolution 2 decimals, offset 4 decimals |
| Source | resolution: a constant per radio family (`E22_RSSI_RESOLUTION_DB` = 1.0, `SX126X_RSSI_RESOLUTION_DB` = 0.5); offset: `[radio] rssi_cal_offset_db` (default 0.0) |
| Formula | the offset C is added to every RSSI and noise reading, including the ground RF survey (GSCAN) bars |
| Updates | configuration only |
| This hardware | C comes from test T-RF-02 (a known signal level into the station radio); until it is done the absolute level of every RSSI and noise value is uncalibrated (VERIFY on hardware) |
| Meaning | the resolution is the step of one reading; the offset sets the absolute accuracy |
| If abnormal | an offset of several dB with no test record behind it: correct `station.toml` ([15_Configuration_Reference.md](15_Configuration_Reference.md)) |
| Related | every RSSI and noise value, the link budget's measured column, the TDM `CARRIER_POWER` |
| Example | 1.00 dB / 0.0000 dB (E22, uncalibrated default) |

#### Received power, linear

| | |
|---|---|
| Shown as | "Received power, linear" |
| Key | `rx.rf.rssi_mw` (milliwatts in the snapshot) |
| Unit, display | the page multiplies by 1e9 and shows picowatts with 5 significant digits |
| Formula | P[mW] = 10^(RSSI_cal / 10) |
| Updates | every reception |
| Meaning | the same reading on a linear scale: useful to see that -110 dBm is ten times the power of -120 dBm |
| Example | -113 dBm = 5.0119e-12 mW, shown as "0.0050119 pW"; the screenshot's -108 dBm is "0.015849 pW" |

#### Noise floor, noise source, noise reading age

| | |
|---|---|
| Shown as | "Noise floor (calibrated)", "Noise source", "Noise reading age" |
| Keys | `rx.rf.noise_dbm`, `rx.rf.noise_source`, `rx.rf.noise_age_s` |
| Unit, display | dBm at the resolution (whole dB with the E22, 0.1 dB with the SX126x); text; s 1 decimal |
| Source | E22: the ambient-noise register, read with the query C0 C1 C2 C3 (reply C1 00 02 <noise> <last RSSI>), dBm = -(256 - octet); needs `[radio] rssi_noise = true`. SX126x: the station MCU's `rf_noise` RPC, the median of 8 instantaneous RSSI samples (GetRssiInst) in 0.1 dBm. Source text: "E22 noise register" or "SX126x GetRssiInst median of 8" |
| Formula | noise_cal = noise_raw + C (the same calibration offset as the RSSI) |
| Updates | one reading at most every `[radio] noise_poll_s` (default 20 s, minimum 5 s), requested in the quiet window after a received frame when no command is waiting. No frames, no new noise readings: the age grows during LOS |
| This hardware | the physical floor is thermal noise kTB in the receiver bandwidth plus the receiver noise figure. kTB is -123.0 dBm in 125 kHz, -126.0 dBm in 62.5 kHz, -129.1 dBm in 31.25 kHz; with the assumed SX126x noise figure of 6 dB that is about -117.0 / -120.0 / -123.1 dBm (computed). The E22's internal bandwidth and noise figure are not published, so its quiet-site reading must be recorded on site (VERIFY on hardware; [21_Test_Records.md](21_Test_Records.md)). The simulator models -118 dBm |
| Meaning | how much power the receiver hears when the spacecraft is silent. Local interference (switch-mode supplies, computers, other transmitters) raises it and eats margin the link budget does not know about |
| If abnormal | a floor well above your recorded quiet-site value: find the source with a ground RF survey (GSCAN, [4.17](#417-rf-survey)) and move to the quietest allowed channel (LINKCHAN); an age that keeps growing during AOS: noise queries are not answered (E22: `rssi_noise` off, or the RCU / serial link; see "Noise queries / replies" in [4.14](#414-serial-and-radio-link)) |
| Related | SNR est., N0 est., the link budget "Thermal noise kTB" row, the RF survey |
| Example | E22: -119.0000 dBm, "E22 noise register", age 5.4 s; SX126x: -117.4000 dBm, age 37.5 s |

#### SNR est. (RSSI - noise)

| | |
|---|---|
| Shown as | "SNR est. (RSSI − noise)" |
| Key | `rx.rf.snr_est_db` |
| Unit, display | dB at the readings' resolution (1.5) |
| Formula | SNR_est = RSSI_cal - noise_cal, shown only when the noise reading belongs to the same pass as the RSSI: their times differ by no more than the LOS timeout (90 s before the first housekeeping tick); otherwise "—" (an RSSI minus a noise reading taken hours later was never an SNR) |
| Updates | every reception (with the newest noise reading) |
| This hardware | E22: the only SNR there is. LoRa demodulates below the noise, so SNR est. goes negative near the limit: at the datasheet sensitivity of -128 dBm with a floor near -118 dBm it would read about -10 dB. SX126x: compare with the measured SNR, which is the better number |
| Meaning | how far the packet stood above the noise the receiver hears between packets |
| If abnormal | falling SNR est. at constant RSSI: the noise floor rose (interference); "—" during a pass: no fresh noise reading (see the noise age) |
| Related | packet RSSI, noise floor, SNR measured, link margin est. |
| Example | E22: -113 - (-119) = 6.0000 dB; SX126x: -126.0 - (-117.4) = -8.6000 dB (measured SNR of the same packet: -6.25 dB) |

#### Signal power est. (noise removed)

| | |
|---|---|
| Shown as | "Signal power est. (noise removed)" |
| Key | `rx.rf.pr_est_dbm` |
| Unit, display | dBm at the readings' resolution (1.5) |
| Formula | P_r = 10 log10(10^(RSSI_cal/10) - 10^(noise_cal/10)): the RSSI includes the noise power in the bandwidth, so the noise is subtracted on a linear scale. "—" when RSSI <= noise (the difference is not positive) or a value is missing |
| Updates | every reception |
| This hardware | equals RSSI within 0.1 dB when the RSSI is 15 dB or more above the noise; undefined for LoRa packets received below the noise floor |
| Meaning | the carrier power alone; the E22 C/N0 est. is built on it |
| Related | packet RSSI, noise floor, C/N0 est. |
| Example | 10 log10(10^-11.3 - 10^-11.9) = -114.2563 dBm for RSSI -113 and noise -119 dBm; SX126x example: "—" (RSSI -126.0 is below the noise -117.4) |

#### N0 est., noise bandwidth and its basis

| | |
|---|---|
| Shown as | "N₀ est.", "Noise bandwidth", "Noise-bandwidth basis" |
| Keys | `rx.rf.n0_est_dbm_hz`, `rx.rf.noise_bw_hz`, `rx.rf.noise_bw_source` |
| Unit, display | dBm/Hz at the readings' resolution (1.5); Hz 1 decimal; text |
| Formula | N0 = noise_cal - 10 log10(B). B = the LoRa profile bandwidth for the SX126x (basis "profile BW"); `[radio] noise_bw_hz` (default 125000 Hz) for the E22 (basis "assumed": EBYTE does not publish the bandwidth behind each air rate) |
| Updates | with the noise reading; B with the configuration |
| This hardware | thermal limit -174 dBm/Hz plus the receiver noise figure: about -168 dBm/Hz for a 6 dB noise figure |
| Meaning | noise power in 1 Hz, the reference for C/N0 |
| If abnormal | N0 more than about 10 dB above -168 dBm/Hz on a quiet site: interference or a wrong noise bandwidth assumption |
| Example | E22: -119 - 10 log10(125000) = -119 - 50.9691 = -169.9691 dBm/Hz; SX126x profile 1: -117.4 - 47.9588 = -165.3588 dBm/Hz |

#### C/N0 est. and its basis

| | |
|---|---|
| Shown as | "C/N₀ est.", "C/N₀ basis" |
| Keys | `rx.rf.cn0_est_dbhz`, `rx.rf.cn0_source` |
| Unit, display | dB-Hz at the readings' resolution (1.5); text |
| Formula | SX126x: C/N0 = SNR_meas + 10 log10(B) (basis "measured SNR + 10 log10(profile BW)"); E22: C/N0 = P_r - N0 (basis "estimate: (RSSI - noise) / assumed noise bandwidth") |
| Updates | every reception |
| This hardware | the LoRa demodulator limit SNRmin (Semtech, `LORA_SNR_MIN_DB`) corresponds to C/N0 = SNRmin + 10 log10(B): 25.0 dB-Hz (profile 0), 28.0 (1), 31.0 (2), 33.5 (3), 36.0 (4), 38.5 (5), 41.0 (6), 43.5 dB-Hz (7). More than 6 dB above that is comfortable, 3 to 6 dB marginal, less than 3 dB poor (the dashboard's margin bands). For the E22 there is no published threshold: use the link margin |
| Meaning | carrier power per unit noise density: independent of the bandwidth, so it compares different radio settings |
| If abnormal | E22 "—": RSSI was not above the noise (P_r undefined) |
| Related | SNR, N0 est., Eb/N0 est. |
| Example | E22: -114.2563 - (-169.9691) = 55.7128 dB-Hz; SX126x profile 1: -6.25 + 47.9588 = 41.7088 dB-Hz (13.75 dB above the 27.96 dB-Hz limit) |

#### Eb/N0 est.

| | |
|---|---|
| Shown as | "Eᵦ/N₀ est." |
| Key | `rx.rf.ebn0_est_db` |
| Unit, display | dB at the readings' resolution (1.5) |
| Formula | Eb/N0 = C/N0 - 10 log10(Rb), Rb = the air data rate above (nominal LoRa bit rate for the SX126x) |
| Updates | every reception |
| This hardware | at the LoRa demodulator limit every profile needs about 6.0 to 6.3 dB (SNRmin + 10 log10(B) - 10 log10(Rb)); SF12 profiles 6.30 dB |
| Meaning | energy per bit relative to the noise density: the figure coding textbooks use |
| Related | C/N0 est., air data rate |
| Example | E22: 55.7128 - 10 log10(2400) = 21.9107 dB; SX126x profile 1: 41.7088 - 21.6577 = 20.0509 dB |

#### Sensitivity and its source

| | |
|---|---|
| Shown as | "Sensitivity" (with a source badge) and "Sensitivity source" |
| Keys | `rx.rf.sensitivity_dbm`, `rx.rf.sensitivity_source` |
| Unit, display | dBm, 4 decimals; text and badge |
| Source | `link.sensitivity()` for the station model and rate code. In order of precedence: **measured**: `[radio.sensitivity_measured] "<MODEL>:<code>" = dBm` from test T-RF-03; **datasheet**: E22-400T33D -128 dBm, E22-400T37S -126 dBm at 2.4 kbit/s (codes 0-2), SX126x where Semtech DS rev 2.2 Table 3-8 lists the profile (SF12/125 kHz -137 dBm, SF7/125 kHz -124 dBm); **estimated**: E22 above 2.4 kbit/s, S = S(2.4k) + 10 log10(Rb / 2400), rounded to 0.1 dB; **computed**: SX126x S = -174 + 10 log10(B) + NF + SNRmin(SF), NF = 6 dB (assumed, boosted gain), rounded to 0.1 dB |
| Updates | configuration only (rate code, model) |
| This hardware | E22-400T33D: -128.0 (codes 0-2), -125.0, -122.0, -119.0, -116.0, -113.8 dBm (codes 3-7); E22-400T37S 2 dB less sensitive (-126.0 ... -111.8 dBm); SX126x profiles 0-7: -143.1, -140.0, -137.0, -134.5, -132.0, -129.5, -127.0, -124.0 dBm |
| Meaning | the weakest signal the receiver decodes (the reference for the margin). Only "measured" values are facts about your hardware; the rest are the manufacturer's or the formula's |
| If abnormal | frames failing well above the shown sensitivity: the real sensitivity is worse (interference, a poor module, a wrong noise figure); run T-RF-03 and enter the result |
| Related | link margin est., link manager, the link budget |
| Example | -128.0000 dBm, "datasheet" (E22-400T33D, code 2); -140.0000 dBm, "computed" (SX126x profile 1); the screenshot: -113.8000 dBm, "estimated" (E22 code 7) |

#### Link margin est. (RSSI - sensitivity)

| | |
|---|---|
| Shown as | "Link margin est. (RSSI − sensitivity)"; also the header MARGIN, the OVERVIEW tile and the link budget "= Link margin" (measured) |
| Key | `rx.rf.margin_est_db` |
| Unit, display | dB at the readings' resolution (1.5) |
| Formula | M = RSSI_cal - S |
| Updates | every reception |
| This hardware | colour bands (dashboard.html): green >= 6 dB, amber 3 to 6 dB, red < 3 dB. The link manager aims for `[linkmgr] target_margin_db` = 6 dB on the 10th-percentile margin of the last 10 minutes ([4.16](#416-link-manager-and-pass-events)) |
| Meaning | how many dB the signal could lose before reaching the decode threshold. Because one reading includes fading, the robust number is the 10-minute p10 of RSSI minus the sensitivity (what the link manager uses) |
| If abnormal | below 3 dB: expect lost frames; slow down (LINKRATE to a lower code), improve antennas, height or feeders, or accept the losses. Negative but frames still arrive: the shown sensitivity is pessimistic (or the RSSI calibration is off) |
| Related | packet RSSI, sensitivity, FER, link manager, range at sensitivity |
| Example | E22: -113 - (-128) = 15.0000 dB; SX126x: -126 - (-140) = 14.0000 dB |

#### Required SNR and SNR margin (SX126x)

| | |
|---|---|
| Shown as | "Required SNR (LoRa SNRmin of the SF)", "SNR margin (measured − required)" |
| Keys | `rx.rf.required_snr_db`, `rx.rf.snr_margin_db` |
| Unit, display | dB, 2 decimals; "—" for the E22 |
| Formula | required = SNRmin(SF): SF7 -7.5, SF8 -10, SF9 -12.5, SF10 -15, SF11 -17.5, SF12 -20 dB (Semtech, `LORA_SNR_MIN_DB`); SNR margin = SNR_meas - required |
| Updates | every SX126x packet |
| This hardware | a direct demodulator margin, independent of any RSSI calibration. Read it with the same bands as the link margin (>= 6 dB good, 3 to 6 marginal, < 3 poor). The AFC trusts a packet's frequency error only when SNR >= SNRmin + 3 dB |
| Meaning | how much SNR the LoRa demodulator had to spare on the newest packet |
| If abnormal | SNR margin much smaller than the link margin: the noise floor is higher than the sensitivity formula assumes (interference) |
| Example | SX126x profile 1: required -20.00 dB; SNR -6.25 dB gives 13.7500 dB |

#### Frequency-offset limit, error median and state (SX126x)

| | |
|---|---|
| Shown as | "Frequency-offset limit FERR_L", "\|Frequency error\| median", "Frequency-offset state" |
| Keys | `rx.rf.freq_offset_limit_hz`, `rx.rf.freq_offset_abs_median_hz`, `rx.rf.freq_offset_state` |
| Unit, display | Hz 1 decimal; Hz 1 decimal; OK (green), WARN (amber), ALARM (red); "—" for the E22 |
| Source | FERR_L: Semtech DS Table 3-8: ±25 % of the bandwidth, and at SF12 / SF11 / SF10 also ±50 / ±100 / ±200 ppm of the carrier, the tighter applying (`link.lora_max_freq_offset_hz()`). Median: of \|raw frequency error\| over the last 3 packets (`FREQ_STATE_SAMPLES`) |
| Formula | state = ALARM if median > 0.8 FERR_L, WARN if > 0.5 FERR_L, else OK (`link.freq_offset_state()`) |
| Updates | every SX126x packet |
| This hardware | FERR_L at 433.125 MHz: profile 0 7812.5 Hz, profile 1 15625 Hz, profile 2 21656.25 Hz (the 50 ppm limit), profiles 3-7 31250 Hz |
| Meaning | beyond FERR_L the receiver loses sensitivity. With the AFC running the raw error is what remains after the correction, so a growing median means the AFC is not keeping up |
| If abnormal | WARN raises a YELLOW alarm, ALARM a RED one ([15](#15-alarm-logic)): check the AFC state ([4.7](#47-afc)); if the AFC is off or in FAULT, calibrate the static offset ([radio] `freq_offset_cal_hz`, T-RF frequency calibration in docs/08) |
| Related | frequency error (last packet, 10-min window, chart, gauge, histogram), AFC, Doppler |
| Example | SX126x profile 1: limit 15625.0 Hz, median 449.0 Hz (2.9 %), state OK |

#### CRC-failed packets and packet error rate (SX126x)

| | |
|---|---|
| Shown as | "CRC-failed packets", "Packet error rate (CRC)" |
| Keys | `rx.rf.crc_fail_packets`, `rx.rf.packet_error_rate` |
| Unit, display | count; scientific; "—" for the E22 |
| Formula | PER = CRC-failed / (CRC-good + CRC-failed) over every SX126x packet since the GDS started |
| Updates | every SX126x packet |
| This hardware | a CRC-failed packet of exactly one CADU still goes to the Reed-Solomon decoder ("RS rescue", [4.10](#410-decoder)), so a PER of a few per cent need not lose frames. Read it with the FER bands: < 1 % good, 1-10 % marginal, > 10 % bad |
| Meaning | how many LoRa packets arrived damaged |
| Related | RS rescued / rescue failed, FER, SNR margin |
| Example | 3 CRC failures in 57 packets: PER = 3/57 = 5.26e-2; all 3 rescued by RS |

#### Last packet and the 10-minute summaries

| Shown as | Key | Unit, display | Meaning |
|---|---|---|---|
| RSSI | `rx.rf.packet.rssi_dbm` | dBm at the resolution (1.5) | the newest reception's calibrated RSSI |
| SNR (SnrPkt/4) | `rx.rf.packet.snr_db` | dB, 2 decimals | SX126x measured SNR (0.25 dB steps); "—" for the E22 |
| Frequency error (raw) | `rx.rf.packet.freq_err_hz` | Hz, 1 decimal | SX126x LoRa frequency-error estimate, before calibration and AFC sign (`rf_rx` freq_err_hz) |
| CRC | `rx.rf.packet.crc_ok` | ok / FAILED (amber) | the LoRa payload CRC (E22 receptions are "ok") |
| Time | `rx.rf.packet.t` | ISO 8601 | when the reception reached the GDS (ERT) |
| SNR window 10 min | `rx.rf.snr_db` (`mean`, `sem`, `min`, `max`, `n`) | "mean ± SEM dB [min, max] n=" | the measured SNR of the last 10 minutes |
| Frequency error window 10 min | `rx.rf.freq_err_hz` (`mean`, `sem`, `min`, `max`, `n`) | "mean ± SEM Hz [min, max] n=" | the raw frequency error of the last 10 minutes |

Example (SX126x): last packet RSSI -126.0000 dBm, SNR -6.2500 dB, frequency error 469.0 Hz,
CRC ok; SNR window -4.6538 ± 0.4647 dB [-8.0000, -2.7500] n=13; frequency-error window
407.9 ± 9.9 Hz [354.0, 469.0] n=13. The nested blocks `rx.rf.doppler` and `rx.rf.afc` have
their own panels ([4.8](#48-doppler-and-range-rate), [4.7](#47-afc)).

### 4.3 Receiver statistics

**What it shows.** The wide table: eight measured quantities, each in the three windows
(1 min, 10 min, pass), each with the eleven statistics of
[section 1.6](#16-the-statistics-windows-explained). Keys:
`rx.windows.<window>.<metric>.<stat>` with window `1m`, `10m` or `pass`, the metrics below,
and stat one of `n`, `mean`, `sem`, `std`, `min`, `p10`, `p50`, `p90`, `max`, `last`,
`fade_depth` (pass windows also carry `truncated`). A row shows "—" until its window holds
a sample.

| Metric (as shown) | Metric key | Unit, decimals | A sample is added | This hardware; how to read it |
|---|---|---|---|---|
| Packet RSSI (dBm) | `rssi` | dBm, 4 | every reception (calibrated) | the link level. p10 = the level held 90 % of the time; fade depth = p90 - p10 |
| Noise floor (dBm) | `noise` | dBm, 4 | every noise reading (at most one per 20 s) | should be flat; σ above about 1 dB or steps mean changing interference |
| SNR est. (RSSI − noise) (dB) | `snr_est` | dB, 4 | every reception, paired with the newest noise reading of any age | see the SNR est. card; the first frames of a pass can pair with the previous pass's last noise reading |
| SNR measured (SX126x) (dB) | `snr_meas` | dB, 4 | every SX126x packet | compare the mean with the required SNR of the profile |
| Frequency error (Hz) | `freq_err` | Hz, 1 | every SX126x packet (raw) | with AFC: the residual after the correction; σ = frequency jitter |
| Frame inter-arrival (s) | `iat` | s, 4 | every frame after the first of a pass: time since the previous frame | p50 = the spacecraft frame period ([1.3](#13-how-often-things-change)); max or p90 above it = gaps (lost frames, an RF survey, a hibernation beacon) |
| RS symbols corrected / codeblock (sym) | `rs` | symbols, 4 | every correctable codeblock: 0..16 | 0 at good SNR; a mean rising toward 16 means the decoder is near its limit (E = 16 per codeword) |
| ASM bit errors / frame (bit) | `asm` | bits, 4 | every codeblock: 0..4 | bit errors in the 32-bit sync marker, which RS does not protect; accepted up to 2 while searching and 4 in lock |

Example (E22 at 2.4 kbit/s, CRUISE, 10-minute window), the full-precision values of the snapshot
(`rx.windows`); the page shows the received-power rows at the readings' resolution (1.5), here
-112, —, 3, -120, -116, -112, -108, -106, -113 and 8 (the ± SEM column shows "—" on these rows:
the SEM lies below the resolution; the snapshot keeps it):

| Metric | n | mean | ± SEM | σ | min | p10 | p50 | p90 | max | last | fade p90-p10 |
|---|---|---|---|---|---|---|---|---|---|---|---|
| Packet RSSI (dBm) | 178 | -111.9213 | 0.2144 | 2.8530 | -120.0000 | -116.0000 | -112.0000 | -108.0000 | -106.0000 | -113.0000 | 8.0000 |
| Noise floor (dBm) | 26 | -118.1154 | 0.1154 | 0.5769 | -119.0000 | -119.0000 | -118.0000 | -117.5000 | -117.0000 | -119.0000 | 1.5000 |
| SNR est. (dB) | 178 | 6.1236 | 0.2167 | 2.8828 | -2.0000 | 2.0000 | 6.0000 | 10.0000 | 13.0000 | 6.0000 | 8.0000 |
| Frame inter-arrival (s) | 178 | 3.3627 | 0.0505 | 0.6714 | 3.2000 | 3.2000 | 3.2200 | 3.2200 | 6.4600 | 3.2000 | 0.0200 |
| RS symbols / codeblock | 178 | 1.3371 | 0.0858 | 1.1411 | 0.0000 | 0.0000 | 1.0000 | 3.0000 | 3.0000 | 0.0000 | 3.0000 |
| ASM bit errors / frame | 178 | 0.0000 | 0.0000 | 0.0000 | 0.0000 | 0.0000 | 0.0000 | 0.0000 | 0.0000 | 0.0000 | 0.0000 |

Reading it: the median inter-arrival time of 3.22 s is close to the CRUISE frame period of
3.17 s at 2.4 kbit/s, the 6.46 s maximum is one lost frame (twice the period), and the RSSI
p10 of -116 dBm is 12 dB above the -128 dBm sensitivity: the 10th-percentile margin the
link manager works with. (The RS corrections are the simulator's injected errors, up to 3
per frame.)

### 4.4 Charts and histograms

| Panel | Keys | What it shows; how to read it |
|---|---|---|
| Packet RSSI and noise floor | `rx.series.t`, `rx.series.rssi`, `rx.series.noise` | the last 300 frames (`SERIES_LEN`), dBm. RSSI tracking the noise line = no margin left |
| SNR and margin | `rx.series.snr_est`, `rx.series.snr_meas`, `rx.series.margin` | the last 300 frames, dB, red dashed line at 0 dB. Margin below 0 dB means frames are decoding below the stated sensitivity |
| Frequency error | `rx.series.freq_err` | raw LoRa estimate per frame, Hz, with dashed WARN (±50 %) and ALARM (±80 %) lines of FERR_L. E22: "no frequency-error reports (SX126x only)" |
| (snapshot only) | `rx.series.rs` | RS symbols corrected in each of the last 300 frames (not charted; the histogram below summarises it) |
| Frequency-error gauge | `rx.windows.10m.freq_err.mean`, `.sem`, `rx.rf.freq_offset_limit_hz` | the 10-minute mean (bar) ± SEM (shaded) on a ±FERR_L scale with OK / WARN / ALARM zones; note line: "10-min mean x Hz ± y Hz of FERR_L z Hz = p % · state S" |
| RSSI distribution | `rx.hist.rssi` (`lo` -150, `step` 5, `bins`) | count of receptions per 5 dB bin since the GDS started ("whole session"); a two-humped shape = two conditions (e.g. antenna moved) |
| SNR distribution | `rx.hist.snr` (`lo` -30, `step` 2) | per 2 dB bin; the measured SNR when the radio gives one, else SNR est. |
| Frequency-error distribution | `rx.hist.freq_err` (±FERR_L, or ±5000 Hz without one; `step` 100) | per 100 Hz bin |
| RS corrections per codeblock | `rx.hist.rs_corrections` | 17 counters: codeblocks that needed 0, 1, ... 16 symbol corrections. Weight moving right = the link is approaching the RS limit |
| ASM bit errors per frame | `rx.hist.asm_bit_errors` | 5 counters: 0..4 bit errors in the sync marker |

Values outside a histogram's range are counted in the end bins. Charts show only the bins
around the data (two empty bins either side); hover a bar or point for its exact value and
time.

### 4.5 Link budget

**What it shows.** The free-space link budget for the configured geometry ("design") next to
what the receiver actually measures ("measured"), for the downlink (spacecraft to station)
and the uplink (station to spacecraft). Key prefix `rx.budget` (`ReceiverStats._budget()`).
The panel's subtitle shows the formula:
FSPL = 20·log10(4π·d·f/c) = 32.44778 + 20·log10(d/km) + 20·log10(f/MHz) dB, with the exact
constant (c = 299 792 458 m/s; 20 log10(4π x 10⁹ / c) = 32.44778, not the rounded 32.44).

Symbols: P_t transmitter power (dBm), G_t / L_t spacecraft antenna gain (dBi) and line loss
(dB), G_r / L_r station antenna gain and line loss, d distance, f carrier frequency, S
receiver sensitivity, N noise floor, RSSI the measured received power.

**Downlink rows**

| Row | Design key | Measured key | Formula, source | Badge |
|---|---|---|---|---|
| S/C transmitter power (model) | `rx.budget.sc_tx_power_dbm_nominal` | - | P_t = `link.power_dbm()` of the spacecraft's model and power code from the RF packet (`tx_power_code`); "—" until an RF packet arrives. T33D 33/30/27/24 dBm, T37S 37 dBm on every code, SX126x 22/17/14/10 dBm drive + 11 dB PA (33/28/25/21 dBm). `rx.budget.sc_model` names the model, `rx.budget.power_verified` is true only for the T37S | datasheet or VERIFY T-RF-07 |
| − S/C line loss | `rx.budget.sc_line_loss_db` | - | `[spacecraft] tx_line_loss_db` (default 0.5 dB) | configured |
| + S/C antenna gain | `rx.budget.sc_antenna_gain_dbi` | - | `[spacecraft] antenna_gain_dbi` (default 2.15 dBi) | configured |
| = EIRP | `rx.budget.sc_eirp_dbm_est` | - | EIRP = P_t + G_t - L_t | est. |
| Distance / one-way light time | `rx.budget.distance_km` | `rx.budget.owlt_s` | `[spacecraft] distance_km`; OWLT = d / c. 0 km gives "—" and no free-space loss | configured |
| − Free-space path loss | `rx.budget.fspl_db` | `rx.budget.measured_path_loss_db_est` (last) | FSPL = 20 log10(4π d f / c) (`rxstats.fspl_db()`, formula text in `rx.budget.fspl_formula`); measured path loss = EIRP + G_r - L_r - RSSI_cal | computed, measured |
| path loss 10-min mean | - | `rx.budget.measured_path_loss_mean10m_db` | EIRP + G_r - L_r - (10-minute RSSI mean) | measured |
| + Ground antenna gain | `rx.budget.ground_gain_dbi` | - | `[station] antenna_gain_dbi` (default 12.0 dBi) | configured |
| − Ground line loss | `rx.budget.ground_line_loss_db` | - | `[station] rx_line_loss_db` (default 1.0 dB) | configured |
| = Received power | `rx.budget.predicted_pr_dbm` | 10-min RSSI mean (n), at the readings' resolution | P_r,pred = EIRP + G_r - L_r - FSPL | computed, measured |
| Excess loss (measured − free space) | - | `rx.budget.excess_loss_db_est` | measured path loss (last) - FSPL; amber above 20 dB | est. |
| Thermal noise kTB (NF assumed) | `rx.budget.thermal_noise_dbm` | 10-min noise mean, at the readings' resolution | kTB = -174 + 10 log10(B) dBm (B = noise bandwidth, [4.2](#42-rf-now)); the NF shown for the SX126x is `rx.budget.noise_figure_assumed_db` = 6 dB ("—" for the E22) | computed, measured |
| SNR | `rx.budget.predicted_snr_db` | 10-min measured SNR mean (SX126x) or SNR est. mean | predicted P_r - current noise floor | measured or est. |
| Sensitivity | `rx.budget.sensitivity_dbm` (+ `rx.budget.sensitivity_source`) | - | as in [4.2](#42-rf-now) | source badge |
| = Link margin | `rx.budget.predicted_margin_db` | `rx.rf.margin_est_db` (coloured as in 4.2) | predicted P_r - S; measured RSSI_cal - S | est. |
| Range at sensitivity (free space + excess loss) | - | `rx.budget.range_at_sensitivity_km_est` | the distance at which free space plus the measured excess loss would bring the signal down to S: d_max = (c / 4πf) x 10^((EIRP + G_r - L_r - S - L_excess) / 20) (`rxstats.range_for_loss_m()`). With the measured excess loss this equals d x 10^(M/20); without a measurement (no RSSI yet) the excess loss is taken as 0 (pure free space) | est. |

**Uplink rows** (station to spacecraft; keys under `rx.budget.uplink`)

| Row | Design key | Measured key | Formula, source | Badge |
|---|---|---|---|---|
| Station transmitter power | `rx.budget.uplink.gs_power_dbm` | - | `link.power_dbm()` of the station model, `[radio] power` code and, for the SX126x, `[radio.sx126x] pa_gain_db`; `rx.budget.uplink.gs_power_verified` true only for the T37S | datasheet or VERIFY T-RF-07 |
| Station EIRP | `rx.budget.uplink.gs_eirp_dbm_est` | - | P_gs + G_r - L_r (the station antenna and cable serve both directions) | est. |
| S/C sensitivity | `rx.budget.uplink.sc_sensitivity_dbm` (+ `rx.budget.uplink.sc_sensitivity_source`) | - | `link.sensitivity()` of the spacecraft's model and rate code from the RF packet, with its Rx boosted gain from RF `rf_flags` b0 for the SX126x. Station T-RF-03 measurements are not applied to the spacecraft | source badge |
| Received power at the S/C | `rx.budget.uplink.predicted_pr_dbm` | `rx.budget.uplink.measured_uplink_rssi_dbm` ("(RF uplink_rssi)") | predicted: EIRP_gs + G_t - L_t - FSPL; measured: the RSSI of the last uplink packet as the spacecraft reports it (RF `uplink_rssi`, 1 dB, not calibrated) | computed, measured |
| Uplink margin | `rx.budget.uplink.predicted_margin_db` | `rx.budget.uplink.measured_margin_db` | received power at the spacecraft - spacecraft sensitivity | est. |

**Worked example** (simulator snapshot, E22-400T33D at code 2, configured d = 2 km,
f = 433.125 MHz, all other values the `station.toml` defaults):

1. EIRP = 33.00 + 2.15 - 0.50 = 34.65 dBm (`sc_eirp_dbm_est`).
2. FSPL = 20 log10(4π x 2000 m x 433.125e6 Hz / 299792458 m/s) = 91.2006 dB; check with
   the km/MHz form: 32.44778 + 20 log10(2) + 20 log10(433.125) = 32.4478 + 6.0206 + 52.7322
   = 91.2006 dB.
3. Predicted received power = 34.65 + 12.00 - 1.00 - 91.2006 = -45.5506 dBm.
4. Predicted margin = -45.5506 - (-128) = 82.4494 dB; predicted SNR = -45.5506 - (-119)
   = 73.4494 dB.
5. Measured path loss (last) = 34.65 + 12.00 - 1.00 - (-113) = 158.6500 dB; 10-minute mean
   34.65 + 11.00 - (-111.9213) = 157.5713 dB.
6. Excess loss = 158.6500 - 91.2006 = 67.4494 dB (the simulator's RF ignores the distance:
   a real link with 67 dB excess loss at 2 km would be heavily obstructed).
7. Measured margin = -113 - (-128) = 15.0000 dB; range at sensitivity = 2 km x 10^(15/20)
   = 11.247 km.
8. Thermal noise kTB in the assumed 125 kHz = -174 + 50.9691 = -123.0309 dBm, against a
   measured 10-minute noise mean of -118.1154 dBm.
9. Uplink: station EIRP = 33 + 12 - 1 = 44.00 dBm; predicted received power at the spacecraft
   44.00 + 2.15 - 0.50 - 91.2006 = -45.5506 dBm; spacecraft sensitivity -128 dBm
   ("datasheet"), so the predicted uplink margin is 82.4494 dB; the spacecraft reported
   `uplink_rssi` -113 dBm, so the measured uplink margin is 15.0000 dB.

How to use it: the design column says what physics allows in free space; the measured
column says what you get. A large excess loss on a clear line of sight points at the
station (pointing, polarization, cable, connectors, calibration offset); a small excess
loss and a small margin mean the link is simply too long for this rate: use a slower rate
code. Range figures for each radio setting are tabulated in
[02_Link_Budget_and_RF_Analysis.md](02_Link_Budget_and_RF_Analysis.md).

### 4.6 Radio configuration

**What it shows.** How the station radio is configured (`link.describe()` of the station's
settings), what the spacecraft reports about its own radio, the state of the station radio
hardware and the ground radio's register read-back. Key prefix `radio`.

**Station radio (`link.describe()`)**

| Shown as | Key | Meaning, source | Example (E22 / SX126x) |
|---|---|---|---|
| Model | `radio.model` | station radio model ([4.2](#42-rf-now)) | E22-400T33D / SX126x |
| Model id | `radio.model_id` | the RF-packet code of the model: 1 E22-400T33D, 2 E22-400T37S, 3 SX126x | 1 / 3 |
| (not shown) | `radio.model_auto` | true when `[radio] model` is "auto" or absent: the GDS follows the E22 model the spacecraft reports | false |
| Interface | `radio.interface` | UART (E22 firmware) or SPI (RadioLib on the station MCU) | UART / SPI |
| Packet mode | `radio.packet_mode` | yes = whole packets with per-packet RSSI, SNR and frequency error (SX126x) | no / yes |
| Channel | `radio.channel` | `[radio] channel` (LINKCHAN changes it) | 23 |
| Frequency (MHz) | `radio.freq_mhz` | 410.125 + channel | 433.1250 |
| Rate code | `radio.rate_code` | `[radio] air_rate` (LINKRATE changes it) | 2 / 1 |
| Rate | `radio.rate_label` | as `rx.rf.rate_label` | 2.4k / SF12 BW62.5 CR4/5 |
| Bit rate (bit/s) | `radio.bps` | nominal air data rate, rounded to 3 decimals | 2400 / 146.4840 |
| Spreading factor | `radio.sf` | SX126x only | — / 12 |
| Bandwidth (kHz) | `radio.bw_khz` | SX126x only | — / 62.5000 |
| Coding rate | `radio.cr` | SX126x: 4/5 for every profile | — / 4/5 |
| LDRO | `radio.ldro` | SX126x LowDataRateOptimize, on when the symbol time is >= 16.38 ms (profiles 0-3) | — / yes |
| Power code | `radio.power_code` | `[radio] power` (0..3), the station transmitter | 0 |
| TX power (dBm) | `radio.power_dbm` (+ `radio.power_verified`) | nominal output for the code: T33D 33/30/27/24, T37S 37, SX126x drive + `[radio.sx126x] pa_gain_db`; badge "datasheet" only for the T37S, else "VERIFY T-RF-07" | 33 (VERIFY) |
| Rx boosted gain | `radio.rx_boost` | SX126x `[radio.sx126x] rx_boosted_gain` (register 0x08AC = 0x96); "—" for the E22 | — / yes |
| CAD before TX | `radio.cad` | SX126x `[radio.sx126x] cad_before_tx`: channel-activity detection before every uplink | — / yes |
| LBT | `radio.lbt` | E22 `[radio] lbt` (listen before talk); "—" for the SX126x | no / — |
| Sensitivity (dBm) | `radio.sensitivity_dbm` (+ `radio.sensitivity_source`) | as in [4.2](#42-rf-now) | -128 datasheet / -140 computed (integral values are printed without decimals) |
| Air time of one CADU (s) | `radio.airtime_s` (+ `radio.airtime_source`) | SX126x: exact LoRa time on air of 236 octets (Semtech formula, "computed"); E22: 236 x 8 x 1.3 / Rb ("estimated", the flight's model) | 1.0227 estimated / 17.3179 computed |
| FERR_L (Hz) | `radio.freq_offset_limit_hz` | as `rx.rf.freq_offset_limit_hz` | — / 15625 |
| Frequency offset calibration (Hz) | `radio.freq_offset_cal_hz` | `[radio] freq_offset_cal_hz`: the static crystal offset between the two radios, the AFC's start value | 0 |
| Fault log | `radio.has_fault_log` | the model can report abnormal status (FF FF FF 0x): E22-400T37S only | no |
| Noise register | `radio.has_noise_register` | the model has the E22 ambient-noise query | yes / no |

**Spacecraft radio (from RF telemetry)**

| Shown as | Key | Meaning; if abnormal | Example |
|---|---|---|---|
| Model seen / mismatch | `radio.model_seen`, `radio.model_mismatch` | the model the spacecraft reports (RF `radio_model`); red **MISMATCH** badge and a YELLOW alarm when it differs from the station's: check `[radio] model` ("E22-400T37S" or "auto" for a T37S) and the spacecraft's T37S jumper (UNO Q A0 to GND) or SX126x build | E22-400T33D |
| S/C model / rate code | `radio.sc_model`, `radio.sc_rate_code` | from the RF packet (the station's own until one arrives) | E22-400T33D / 2 |
| Air time est. (LoRa / UART air time only) | `radio.sc_airtime_s` | air time of one CADU for the spacecraft's setting (`link.airtime_s()`) | 1.0227 s |
| Busy time est. — compare with RF last_airtime | `radio.sc_busy_s_est` | the transmitter busy time per frame as the flight computes it (`link.busy_s()`): E22 UART transfer + air time, SX126x LoRa air time rounded up to whole ms. RF `last_airtime` should agree within its 0.1 s truncation | 1.2670 s / 17.3180 s |
| Longest expected frame period est. | `radio.frame_period_max_s_est` | max(4.0 x busy time, 1.5 s): the SAFE-mode period. The GDS uses it for the LOS timeout (3x), the FOP-1 T1 timer (2x) and the command-verification timeout (4x) | 5.068 s / 69.272 s |

**Station**

| Shown as | Key | Meaning; if abnormal |
|---|---|---|
| Backend | `radio.backend_available`, `radio.backend_error` | whether the GDS has a radio backend; "UNAVAILABLE" with the reason (red badge and a RED alarm "radio backend unavailable: ..."): E22 serial port missing (`[radio] port`, permissions), or no Router Bridge for the SX126x |
| Radio Control Unit | `radio.rcu` | E22: the station MCU drives the module's M0 / M1 and reads AUX ("active"); needed for GSCAN, WAKE, LINKRATE, LINKCHAN and the configuration read-back. SX126x: "n/a" |
| Configured (station.toml) | `radio.configured` (`channel`, `air_rate`, `power`, `lbt`) | the values in the configuration file at start-up |
| Allowed channels | `radio.allowed_channels` | `[radio] allowed_channels`: CHANNEL and LINKCHAN outside this list are refused (licence and band plan) |
| Coordinated change | `radio.link_change` (`kind`, `value`, `state`, ...) | a LINKRATE / LINKCHAN in progress: state WAIT_EXEC (the AIRRATE / CHANNEL command is on its way), WAIT_SWITCH (executed on board; the spacecraft switches after 2 more frames), SWITCHED (the ground switched and sent a NOOP; waiting for the first frame on the new setting). "none" otherwise. No frame after the switch within `revert_s` + 30 s + 2 frame periods: the ground switches back (the spacecraft also reverts by itself without uplink) |
| Radio jobs pending | `radio.jobs_pending` | procedures queued for the radio thread (VERIFY, RADIO, GSCAN, WAKE, SETRATE, SETCHAN, NOISE); they run in the quiet window after a frame. WAKE and GSCAN never start on top of the window's own planned transmissions (`TX_QUIET_JOBS`); a WAKE runs at most once per 10 s (`WAKE_MIN_INTERVAL_S`: each takes an SDLS TC number), and with the SX126x station radio it waits while the radio has not yet reported itself back on the station channel after a survey; a GSCAN waits until the station transmitter is idle (the same channel check included). Either wait lasts at most max(60 s, 2 frame periods), then the job is dropped with a WARN and the jobs behind it run |
| Ground fault | `radio.ground_fault` (`code`, `text`, `t`) | E22-400T37S abnormal-status report from the station module (under-voltage < 4.5 V, over-voltage > 15 V, over-temperature > 120 °C), shown for 5 s after the last report; raises a RED alarm "ground radio fault: ..."; the module stops transmitting until the condition clears: check the station supply and cooling |
| Last GSCAN | `radio.last_scan` | the last ground RF survey ([4.17](#417-rf-survey)) |
| SX126x backend | `radio.sx126x` | the SX126x station MCU block ([4.13](#413-sx126x-station-mcu)); null for the E22 |

**Ground radio read-back** (`radio.ground_config`): the station radio's configuration as read
back at start-up (job VERIFY) and with the RADIO directive. E22 (registers 00..06,
`e22.describe()`): `model`, `address`, `netid`, `uart_bps`, `parity_code`, `air_rate`,
`air_rate_code`, `subpacket_bytes`, `rssi_noise_enable`, `fault_log`, `fault_log_supported`,
`reserved_bits_set`, `power_code`, `power_dbm`, `power_verified`, `channel`, `freq_mhz`,
`rssi_byte`, `fixed_tx`, `relay`, `lbt`, `wor_role`, `wor_cycle`. SX126x (from the MCU status,
`Sx126xBridge.get_config()`): `model`, `channel`, `freq_mhz`, `air_rate_code`, `air_rate`,
`power_code`, `lbt` (CAD before TX), `rx_boost`, `rx_boost_verified`, `freq_offset_hz`,
`tcxo_fallback`, `calib_error`, `cfg_pending`, `chip`, `fw`, `state`, `chip_id`, `tcxo_mv`,
`hw_mismatch`. The GDS compares channel, air-rate code, RSSI byte and noise enable with
`station.toml` and logs "matches station.toml" or "MISMATCH [...]" (event source RADIO). A
mismatch means the two ends will not hear each other or the RSSI byte is missing: fix the
module (RADIO directive after a correction) or the configuration.

### 4.7 AFC

**What it is.** Automatic frequency correction for the SX126x option (`AfcLoop` in
[link.py](../dssq-groundstation/python/dssq/link.py)). Two crystals never agree exactly, and a moving spacecraft adds Doppler; a
LoRa receiver loses sensitivity when the offset approaches FERR_L. The AFC measures the
offset from the frequency error of every good packet and re-tunes the station receiver and
transmitter (station MCU RPC `rf_foff(hz)`), so both directions stay centred. Key prefix
`rx.rf.afc` (null for the E22 or with `[radio.sx126x] afc = false`; the panel then says "not
active").

**How it works.** A packet is used when its CRC is good, \|error\| <= BW/2 and its SNR >=
SNRmin + 3 dB, and not within one air time + 0.5 s after a correction was applied. The
estimate of the total received offset is the median of the last 8 values of (correction +
sign x error). When \|estimate - correction\| exceeds the dead band, the correction steps
toward the estimate by at most the slew limit, never beyond the bound. After each step the
next 3 packets check the sign convention of the chip's frequency-error register (a VERIFY
item): if the residual grew by more than half the step, the sign is inverted once (WARN
event); if it grows again the loop goes to FAULT, returns to the static offset and raises a
YELLOW alarm. During LOS the correction is held for 600 s, then returns to the static
offset `[radio] freq_offset_cal_hz`.

| Shown as | Key | Unit | Meaning, formula | Example (SX126x profile 1) |
|---|---|---|---|---|
| Enabled / state | `rx.rf.afc.enabled`, `rx.rf.afc.state` | - | DISABLED, STATIC (no estimate yet: fewer than 3 accepted packets, or reset), TRACK (estimating and stepping; badge "tracking"), CHECK (sign self-check after a step), HOLD (LOS, holding), FAULT (badge "FAULT: AFC RESET after checking") | yes / TRACK |
| Correction applied | `rx.rf.afc.correction_hz` | Hz, 1 decimal | the offset the station is tuned to now (confirmed by `rf_foff` = 1) | 1254.0 Hz |
| Estimate | `rx.rf.afc.estimate_hz` | Hz | median of (correction + sign x error) over the last 8 accepted packets: the total received offset from the channel centre | 1678.0 Hz |
| Residual | `rx.rf.afc.residual_hz` | Hz | estimate - correction | 424.0 Hz |
| Sign | `rx.rf.afc.sign` | +1 / -1 | the believed sign of the chip's frequency-error register (`rx.rf.afc.sign_flips` counts inversions) | 1 |
| Static offset | `rx.rf.afc.static_hz` | Hz | `[radio] freq_offset_cal_hz` clipped to the bound | 0.0 Hz |
| Doppler part | `rx.rf.afc.doppler_hz` | Hz | estimate - static offset | 1678.0 Hz |
| Pending | `rx.rf.afc.pending_hz` | Hz | a correction sent and not yet confirmed (confirmation expected within 10 s) | — |
| Samples | `rx.rf.afc.samples` | count | accepted packets in the median window (max 8) | 8 |
| Limit / bound / slew | `rx.rf.afc.limit_hz`, `rx.rf.afc.bound_hz`, `rx.rf.afc.slew_hz` | Hz | FERR_L; bound = min(0.8 FERR_L, 50000 Hz); slew = 0.25 FERR_L per step | 15625.0 / 12500.0 / 3906.3 Hz (3906.25 rounded) |
| Dead-band / SNR minimum | `rx.rf.afc.deadband_hz`, `rx.rf.afc.snr_min_db` | Hz; dB | dead band = max(50 Hz, 2 % of BW); SNR minimum = SNRmin(SF) + 3 dB | 1250.0 Hz / -17.00 dB |
| Accepted / rejected SNR / invalid | `rx.rf.afc.accepted`, `rx.rf.afc.rejected_snr`, `rx.rf.afc.rejected_invalid` | counts | packets used; refused for low SNR; refused as invalid (CRC failed, error beyond BW/2, no value) | 54 / 0 / 3 |
| Skipped settling / steps / sign flips | `rx.rf.afc.skipped_settling`, `rx.rf.afc.steps`, `rx.rf.afc.sign_flips` | counts | packets ignored right after a change or while a confirmation is pending; corrections applied; sign inversions | 0 / 1 / 0 |
| RPC failures | `rx.rf.afc.rpc_failures` | count | `rf_foff` answered -1 (out of range), -2 (radio down), or no answer (-3, the GDS's code for a bridge failure or time-out); retried after 5 s | 0 |
| AFC events | `rx.rf.afc.events` (`t`, `level`, `text`) | - | the last 20 AFC events, newest first (also in the event log, source AFC) | - |

**Reading it.** In the example the estimate (1678 Hz) is 424 Hz away from the applied
correction (1254 Hz), less than the 1250 Hz dead band, so the loop holds: a residual inside
the dead band is normal. Profile thresholds at 433.125 MHz:

| Profile | FERR_L | Bound | Slew per step | Dead band | SNR minimum |
|---|---|---|---|---|---|
| 0 (SF12, 31.25 kHz) | 7812.5 Hz | 6250 Hz | 1953.125 Hz | 625 Hz | -17.0 dB |
| 1 (SF12, 62.5 kHz) | 15625 Hz | 12500 Hz | 3906.25 Hz | 1250 Hz | -17.0 dB |
| 2 (SF12, 125 kHz) | 21656.25 Hz | 17325 Hz | 5414.0625 Hz | 2500 Hz | -17.0 dB |
| 3 (SF11, 125 kHz) | 31250 Hz | 25000 Hz | 7812.5 Hz | 2500 Hz | -14.5 dB |
| 4 (SF10, 125 kHz) | 31250 Hz | 25000 Hz | 7812.5 Hz | 2500 Hz | -12.0 dB |
| 5 (SF9, 125 kHz) | 31250 Hz | 25000 Hz | 7812.5 Hz | 2500 Hz | -9.5 dB |
| 6 (SF8, 125 kHz) | 31250 Hz | 25000 Hz | 7812.5 Hz | 2500 Hz | -7.0 dB |
| 7 (SF7, 125 kHz) | 31250 Hz | 25000 Hz | 7812.5 Hz | 2500 Hz | -4.5 dB |

**If abnormal.** FAULT: check the station frequency reference (TCXO, `tcxo_fallback` in the
SX126x panel) and the sign convention (docs/08: offset a signal generator by +1 kHz), then
send the ground directive `AFC RESET`. Many "rejected SNR": the link is too weak for
reliable frequency estimates (normal near the limit). RPC failures: the station MCU or the
Router Bridge (SX126x panel). An estimate pinned at the bound produces the WARN event
"beyond the correction bound": the static offset is far off (calibrate it).

### 4.8 Doppler and range rate

**What it shows.** The frequency shift caused by the spacecraft's motion along the line of
sight, and the corresponding range rate. SX126x only (the E22 reports no frequency error,
the panel shows "—"). Key prefix `rx.rf.doppler`.

| Shown as | Key | Unit, display | Formula, source |
|---|---|---|---|
| Doppler shift | `rx.rf.doppler.doppler_hz` | Hz, 1 decimal | f_D = total received offset - `[radio] freq_offset_cal_hz` (`link.doppler()`) |
| Range rate | `rx.rf.doppler.range_rate_m_s` | m/s, 3 decimals | v_r = -c x f_D / f, c = 299 792 458 m/s, f = `rx.rf.freq_hz`; positive = receding |
| Source | `rx.rf.doppler.source` | text | "afc estimate" (AFC enabled with an estimate: the total offset is `rx.rf.afc.estimate_hz`) or "raw frequency error" (total = correction + sign x raw error of the newest packet) |
| Offset calibration | `rx.rf.doppler.offset_cal_hz`, `rx.rf.doppler.calibrated` | Hz | the static crystal offset subtracted; "(not calibrated: VERIFY T-RF frequency calibration)" while `[radio] freq_offset_calibrated` is false |
| Carrier | `rx.rf.freq_hz` | Hz | the channel frequency |
| Relation | - | text | "v_r = −c·f_D/f, c = 299 792 458 m/s" |

**Worked example.** The simulated estimate is 1678 Hz with no calibration (offset 0):
f_D = 1678 Hz and v_r = -299792458 x 1678 / 433125000 = -1161.447 m/s (approaching at
1.16 km/s). The simulator, however, adds a static crystal offset of 1200 Hz; with
`freq_offset_cal_hz = 1200` the same reading gives f_D = 478 Hz and v_r = -330.853 m/s.
Lesson: until the static offset is calibrated, the "Doppler" is mostly the crystal offset.
A ground test with both radios at rest measures exactly that offset (true Doppler 0); enter
it as `freq_offset_cal_hz` and set `freq_offset_calibrated = true` (only then does the TDM
carry `DOPPLER_INSTANTANEOUS`). For scale: 1 Hz at 433.125 MHz is 0.692 m/s.

### 4.9 Frame synchronizer

**What it shows.** The E22 delivers a byte stream (CADU + RSSI octet per packet, plus noise
replies); the synchronizer finds the 32-bit attached sync marker (ASM 1ACFFC1D) in it with
the classic SEARCH -> LOCK -> FLYWHEEL state machine
([framesync.py](../dssq-groundstation/python/dssq/framesync.py)). The SX126x delivers whole
packets, so its state is PACKET and the counters stay 0. Key prefix `sync`.

| Shown as | Key | Meaning | Normal / abnormal |
|---|---|---|---|
| State | `sync.state` | SEARCH (looking for the ASM, <= 2 bit errors accepted), LOCK (ASM found where expected, <= 4 bit errors accepted), FLYWHEEL (expected ASM missing; up to 3 misses tolerated before SEARCH), PACKET (SX126x) | LOCK during a pass; SEARCH between passes is normal |
| ASMs found | `sync.asm_found` | sync markers found | equals CADUs delivered |
| CADUs delivered | `sync.cadus` | CADUs handed to the decoder | grows by 1 per frame |
| ASM bit errors (total) | `sync.asm_bit_errors` | sum of the bit errors in the found markers | 0 or small |
| Slips | `sync.slips` | the ASM was not at the expected position | each slip is a lost or damaged CADU |
| Flywheel frames | `sync.flywheel_frames` | misses tolerated in FLYWHEEL | rising: octets lost on the air or the UART |
| Lock losses | `sync.lock_losses` | fallbacks from LOCK / FLYWHEEL to SEARCH (also a partial CADU older than 3 s is dropped) | a few per pass at the edge of coverage |
| Discarded octets | `sync.discarded_octets` | octets that were not part of any CADU, noise reply or fault report | grows with interference bursts or UART problems |
| Noise replies parsed | `sync.noise_replies` | E22 noise-register replies found in the stream | equals the noise replies in [4.14](#414-serial-and-radio-link) |
| Ground radio fault reports | `sync.radio_fault_reports` | T37S FF FF FF 0x reports in the stream | 0 |
| Mean ASM bit errors per CADU | `sync.asm_bit_errors` / `sync.cadus` | computed on the page, 4 decimals | 0.0000 |
| Time in lock | `rx.state.time_in_lock_pct` | see [4.18](#418-receiver-state) | - |

Example (E22, 14 min): LOCK, 344 ASMs and CADUs, 0 bit errors, 0 slips, 0 flywheel frames,
0 lock losses, 0 discarded octets, 55 noise replies.

### 4.10 Decoder

**What it shows.** What the CCSDS decoder chain did with every received codeblock:
de-randomization, Reed-Solomon RS(255,223) with E = 16 (up to 16 wrong octets per codeword
are corrected; CCSDS 131.0-B), the frame check (FECF), the header checks, SDLS and the
packet decoders. Key prefix `rx.decoder`.

| Shown as | Key | Meaning, formula | Normal; if abnormal |
|---|---|---|---|
| Codeblocks | `rx.decoder.codeblocks` | codeblocks (one per received CADU) | grows by 1 per frame |
| Clean / corrected | `rx.decoder.clean`, `rx.decoder.corrected` | codeblocks needing no correction / needing 1-16 symbol corrections | mostly clean on a strong link |
| Uncorrectable | `rx.decoder.uncorrectable` | more than 16 symbol errors: the frame is lost (amber when not 0; WARN event "RS uncorrectable codeblock(s)", at most once a minute) | rising: the link is at its limit; slow the rate or improve the antennas |
| Symbols corrected / max in one codeblock | `rx.decoder.symbols_corrected`, `rx.decoder.max_corrections` | total symbol (octet) corrections; the most in one codeblock "of 16" | a max close to 16 means frames are close to loss |
| Symbol error rate est. (SER) | `rx.decoder.symbol_error_rate_est` | SER = symbols corrected / (correctable codewords x 232), 232 = the symbols of one shortened codeword (200 frame + 32 parity) | < 1e-3 good; uncorrectable codewords are not included, so SER understates the channel when CER > 0 |
| Pre-FEC BER est. range [SER/8, SER] | `rx.decoder.bit_error_rate_est_range` | a wrong octet has 1 to 8 wrong bits, so BER lies between SER/8 and SER | - |
| Codeword error rate (CER) | `rx.decoder.codeword_error_rate` | uncorrectable / codeblocks | 0 good; > 1e-2 frames are being lost to bit errors |
| FECF failures after RS | `rx.decoder.fecf_fail_after_rs` | RS succeeded but the frame CRC failed (red when not 0) | should be 0: a miscorrection or a framing mismatch |
| Foreign / bad header | `rx.decoder.foreign_or_bad_header` | frames with another spacecraft id, a malformed header, or (SX126x) a LoRa packet that is not one CADU | another station on the channel, or a wrong `[spacecraft] scid` |
| RS rescued (CRC-failed packets) / failed | `rx.decoder.rs_rescued`, `rx.decoder.rs_rescue_failed` | SX126x packets whose LoRa CRC failed but RS still recovered the frame / did not | rescues show the value of the RS code on the SX126x path |
| Rice errors | `rx.decoder.rice_errors` | SPECBURST payloads that failed CCSDS 121.0 decompression (amber; packet dropped) | 0 |
| Decom errors | `rx.decoder.decom_errors` | packets the dictionary could not decode | 0: a flight / ground dictionary mismatch |
| SDLS rejected | `rx.decoder.sdls_rejected` (`BAD_MAC`, `BAD_IV`, `BAD_SPI`, `BAD_LENGTH`, `REPLAY`) | TM frames refused by SDLS, by verdict ([5.3](#53-sdls-tm-rejections)) | 0 |

**Worked example** (E22, 344 codeblocks): 96 clean, 248 corrected, 0 uncorrectable, 482
symbols corrected, at most 3 in one codeblock. SER = 482 / (344 x 232) = 482 / 79808
= 6.04e-3; BER between 7.55e-4 and 6.04e-3; CER = 0 / 344 = 0. (These are the simulator's
injected errors; a real strong link shows mostly clean codeblocks.)

### 4.11 Frames

**What it shows.** Frames that passed RS and the frame check, what was lost, and the
throughput. Key prefix `rx.frames`.

| Shown as | Key | Unit, display | Formula, meaning | Normal; if abnormal |
|---|---|---|---|---|
| Frames OK / lost | `rx.frames.ok`, `rx.frames.lost` | counts | lost = gaps in the master-channel frame count (TM MCFC, mod 256) or, for USLP, in each VC's frame count | - |
| Frame error rate (since start) | `rx.frames.fer` | scientific; green <= 1e-2, amber > 1e-2, red > 1e-1 | FER = lost / (ok + lost) since the GDS started, including the frames the spacecraft sent while out of view (the counter jump at AOS) | the header FER |
| Frame error rate, 10 min (link manager; inter-pass gaps excluded) | `rx.frames.fer_10m` | scientific, same colours | lost / (lost + received) over the last 600 s, without the AOS frame's jump: the in-pass FER the link manager uses | > 10 % makes the link manager recommend a slower rate |
| Idle (OID) frames | `rx.frames.oid_frames`, `rx.frames.idle_frame_pct` | count (%) | frames carrying only the idle / identification data; % = 100 x OID / OK | high when the spacecraft has little to send |
| Channel efficiency (packet / data-field octets) | `rx.frames.channel_efficiency_pct` | % | 100 x octets of real packets delivered / data-field octets of the data-VC frames received | low = frames padded with idle packets |
| Frames per minute | `rx.frames.frames_per_min` | 2 decimals | frames in the last 60 s x 60 / span, span = min(60 s, time since the GDS started) | 60 / frame period |
| Information rate (60 s) | `rx.frames.info_rate_bps` | bit/s, 2 decimals | bits of real (non-idle) packets in the last 60 s / span | the useful telemetry rate |
| CADU rate on air (60 s) | `rx.frames.cadu_rate_bps` | bit/s, 2 decimals | frames in the last 60 s x 1888 bits (236 octets) / span | the gross channel use |
| (VC / format table) | `rx.frames.by_format` (`TM`, `USLP`), `rx.frames.per_vc` (`<vc>`: `frames`, `lost`) | counts | frames per transfer-frame format; frames and frame-count gaps per virtual channel number (0..3 data, 7 TM OID, 63 USLP OID) | - |
| Passes / this pass | `rx.state.passes`, `rx.state.pass_duration_s` | count / duration | [4.18](#418-receiver-state) | - |
| Time in lock | `rx.state.time_in_lock_pct` | % | [4.18](#418-receiver-state) | - |
| Effective LOS timeout | `rx.state.los_timeout_s` | s | [4.18](#418-receiver-state) | - |

**Worked example** (E22 at 2.4 kbit/s, CRUISE, 14 min): 344 OK, 15 lost:
FER = 15 / 359 = 4.18e-2 (the in-pass 10-minute FER 4.30e-2); 275 OID frames = 79.94 %;
17 frames in the last minute = 17.00 frames/min; CADU rate 17 x 1888 / 60 = 534.93 bit/s
of the 2400 bit/s air rate; information rate 22.00 bit/s; channel efficiency 66.98 %.

### 4.12 Packets per APID

A short table of every packet type received: "packet" (APID in hex and name), count, lost
(sequence-count gaps), "IAT s (meas.)" (measured inter-arrival time) and age. Keys
`apids.<packet>.count`, `apids.<packet>.lost`, `apids.<packet>.iat_s`,
`apids.<packet>.age_s`. The full table with latency is on the FRAMES & PACKETS tab
([6.3](#63-packets-by-apid)). The inter-arrival time is measured because the spacecraft
stretches its packet periods to what the link can carry ([1.3](#13-how-often-things-change)).

### 4.13 SX126x station MCU

**What it shows.** With the SX126x option, the VENTUNO Q MCU (station sketch built with
`DSSQ_RADIO_SX126X = 1`) owns the radio and reports a status line every 5 s (`rf_evt S|...`).
The block is `radio.sx126x` (`Sx126xBridge.snapshot()` in
[sx126x.py](../dssq-groundstation/python/dssq/radio/sx126x.py)); "not in use (E22 station
radio)" otherwise. (In simulation the software spacecraft supplies a reduced set of these
fields.)

| Shown as | Field (`radio.sx126x` ...) | Meaning; if abnormal |
|---|---|---|
| Bridge connected | `connected` | the backend has a status line younger than 15 s; "no" = MCU silent or Router Bridge down (also a RED alarm after 30 s, [15](#15-alarm-logic)) |
| Status age | `mcu_age_s` | seconds since the last status line (normally < 5 s) |
| Chip / TCXO (sketch) | `mcu.chip_id`, `mcu.tcxo_mv`, `hw_mismatch` | the chip (1262 / 1268) and TCXO voltage the sketch was compiled for; red "MISMATCH" badge (and a YELLOW alarm) when they differ from `[radio.sx126x] chip` / `tcxo_v`: rebuild the sketch or fix the configuration (editing `station.toml` cannot change a compiled sketch) |
| State | `mcu.state_name` | OFF, RX, CAD, TX, RESET |
| Firmware, Chip | `mcu.fw`, `mcu.chip` | sketch version text, chip name |
| Channel, Rate code, Power code | `mcu.channel`, `mcu.rate_code`, `mcu.power_code` | the configuration in effect on the MCU |
| rx_ok, rx_crc, rx_hdr | `mcu.rx_ok`, `mcu.rx_crc_err`, `mcu.rx_hdr_err` | packets received with good CRC, with a CRC error, with a header error (counted since the MCU booted) |
| tx_ok, tx_fail | `mcu.tx_ok`, `mcu.tx_fail` | uplink transmissions completed / timed out |
| cad_busy, cad_forced | `mcu.cad_busy`, `mcu.cad_forced` | CAD found the channel busy before an uplink (random back-off) / transmitted anyway after the channel stayed busy for 2 s |
| faults, resets | `mcu.faults`, `mcu.resets` | radio faults (BUSY stuck, SPI error, ...) / radio resets; each fault resets and reconfigures the radio |
| TX queue | `mcu.txq` | uplink frames queued on the MCU (0..4) |
| MCU uptime (s) | `mcu.uptime_s` | seconds since the MCU booted (wraps after 49.7 days) |
| RF offset in effect (Hz) | `mcu.freq_offset_hz` | the AFC offset the radio uses; the backend re-sends the wanted offset if it differs |
| rx_gain_reg (0x08AC) | `mcu.rx_gain_reg` (+ `mcu.rx_boost_verified`) | register read back: 0x96 = Rx boosted gain verified (green badge); "not verified" (amber) costs about 4 dB of sensitivity (Semtech Table 3-8 at SF12 / 125 kHz) |
| other status flags | `mcu.cad_before_tx`, `mcu.rx_boost`, `mcu.tcxo_fallback`, `mcu.cfg_pending`, `mcu.calib_error` | CAD enabled; boosted gain requested; the TCXO did not start and RadioLib fell back to the crystal (VERIFY the module); a configuration change waits for the radio to be idle; a calibration error bit was seen since the last radio initialisation |
| backend counters | `stats` (`rx_packets`, `rx_crc_fail`, `rx_rejected`, `rx_overflow`, `evt_rejected`, `tx_sent`, `tx_busy`, `tx_rejected`, `tx_dropped`, `tx_done`, `tx_failed`, `call_errors`, `e22_queries_ignored`, `mcu_reboots`, `config_pushes`, `foff_set`, `foff_failed`, `foff_resyncs`) | the Linux side of the link: packets accepted, malformed notifications, queue overflows, uplink handling, Router Bridge call failures, MCU reboots detected, configuration and frequency-offset pushes |
| TX backlog / RX queue | `tx_backlog`, `rx_queue` | frames waiting to be handed to the MCU / packets waiting for the GDS |
| (snapshot only) | `tx_hold` | the TX gate (not shown in the RECEIVER table; read it in `/api/state`): null normally. After a survey (`GSCAN`) a text "station radio not yet reported back on CH<n> after a survey (uplinks held)": the TX gate hands nothing to the MCU (uplinks wait in the backlog, `WAKE` waits) until a status line shows the station channel with no change pending, so nothing is radiated on a surveyed channel. Normally it clears with the next status line; it stays after a failed return until the re-sent configuration is applied (ERROR `ground RF survey: the station radio did not return to CH<n> ...`, [14](14_Troubleshooting_and_Event_Response.md) section 4.3) |
| Last CAD, Last TX | `last_cad`, `last_tx` | the result of the last operator CAD and the last finished transmission |

### 4.14 Serial and radio link

**What it shows.** The health of the connection between the GDS and the station radio. Keys
`rx.radio_link` (from the radio backend) and `rx.serial` (from the byte stream).

| Shown as | Key | Meaning; if abnormal |
|---|---|---|
| Connected | `rx.radio_link.connected` | green yes / red no. E22: the serial port is open; SX126x: the MCU status is fresh. Down for more than 30 s raises a RED alarm "ground radio link down for n s"; connect / loss events (source RADIO) |
| Port | `rx.radio_link.port` | E22 serial device, e.g. /dev/ttyUSB0 (`[radio] port`) |
| Faults / reopens | `rx.radio_link.faults`, `rx.radio_link.reopens` | E22 link errors seen / successful reopens after a fault (the backend retries by itself; the GDS reopens the port every 10 s while it is missing) |
| TX dropped | `rx.radio_link.tx_dropped` | octets not sent while the port was down (COP-1 retransmits lost commands) |
| Last error | `rx.radio_link.last_error`, `rx.radio_link.error` | the last OS error text (with a hint: no such device, permission denied: group dialout, port busy, ...) / why no backend exists |
| MCU status age (SX126x) | `rx.radio_link.mcu_age_s` | seconds since the SX126x MCU's last status line |
| Serial octets / rate | `rx.serial.octets`, `rx.serial.octets_per_s` | octets received from the E22 since start / per second over the last 10 s (a pass at 2.4 kbit/s brings about 237 octets per frame period) |
| Noise queries / replies | `rx.serial.noise_queries`, `rx.serial.noise_replies` | noise readings requested / received. More queries than replies: the module ignores the query (`rssi_noise` disabled in its registers) or replies are lost |

### 4.15 Two-way link

**What it shows.** The downlink as the station sees it next to the uplink as the spacecraft
sees it. The spacecraft column comes from the newest real-time RF packet, kept as
`rx.two_way` (every RF field, [7.4](#74-telecom-rf-all-24-fields), plus
`rx.two_way.uplink_margin_db_est`); the station's transmit counters are `rx.uplink`.

| Row | DOWNLINK (station) | UPLINK (spacecraft) | How to read it |
|---|---|---|---|
| RSSI | `rx.rf.rssi_dbm` | `rx.two_way.uplink_rssi` | similar powers both ways mean a balanced link (the station and the spacecraft usually have different powers and antennas) |
| SNR | `rx.rf.packet.snr_db` | `rx.two_way.uplink_snr` | SX126x only |
| Frequency error | `rx.rf.packet.freq_err_hz` | `rx.two_way.uplink_freq_err` | SX126x only; with AFC the spacecraft should see a small error because the station transmits on its corrected frequency |
| Noise floor | `rx.rf.noise_dbm` | `rx.two_way.sc_noise_floor` | the noise each receiver hears |
| Margin est. | `rx.rf.margin_est_db` | `rx.two_way.uplink_margin_db_est` | uplink margin = uplink RSSI - spacecraft sensitivity ([4.5](#45-link-budget)) |
| Frames / CLTUs | `rx.frames.ok` frames | `rx.two_way.cltu_ok` ok / `rx.two_way.cltu_bad` bad | CLTUs decoded and rejected on board |
| Errors corrected | `rx.decoder.symbols_corrected` RS symbols | `rx.two_way.bch_corrected` BCH codeblocks | error-correction workload on each side |
| Transmitted | `rx.uplink.cltus` CLTUs / `rx.uplink.octets` octets (`rx.uplink.framing`) | `rx.two_way.frames_sent` frames, OID `rx.two_way.oid_frames_sent` | what each side sent |
| Duty / airtime total | - | `rx.two_way.tx_duty` % / `rx.two_way.tx_airtime_ms_total` s | spacecraft transmitter use ([7.4](#74-telecom-rf-all-24-fields)) |
| Frame period / last air time | - | `rx.two_way.frame_period_ms` / `rx.two_way.last_airtime` | "≥ 65.535 s (saturated)" and "≥ 25.5 s (saturated; busy est. ...)" when a field is at its limit |
| Radio config / LBT deferrals / timeouts | - | `rx.two_way.radio_cfg_ok` / `rx.two_way.lbt_busy` / `rx.two_way.radio_timeouts` | configuration verified on board, transmissions deferred by LBT / CAD, transmitter time-outs |
| Uplink windows / rejected too long | `rx.uplink.windows` / `rx.uplink.rejected_too_long` | - | uplink windows = quiet windows after received frames in which the station may transmit (one per frame); rejected = commands refused because their frame would exceed 64 octets |

`rx.uplink.last_t` is the time of the last CLTU sent (LINK & SECURITY "Last uplink"). The
uplink is only ever sent in the quiet window right after a received frame (the spacecraft
listens after each transmission), so no downlink means no uplink.
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
