Tanay7/Benchmarks/docs/20_Known_Limitations.md

# 20 - Known Limitations and Open Items

This is the register of everything that is **not yet proven**, **limited on purpose**, or a
**residual risk**. It exists so that nobody has to discover these the hard way, and so that a
reviewer can see exactly what the automated tests do and do not cover.

> **Overall status.** The software passes every automated layer
> ([08_Verification_and_Test.md](08_Verification_and_Test.md) section 1). **The flight App has had one
> bench run on the UNO Q, the spacecraft alone (2026-10-12, [21_Test_Records.md](21_Test_Records.md)
> record 2026-10-12-A), and on 2026-10-13 the ground station received its downlink on the bench
> (record 2026-10-13-A). Commanding: commands sent by hardline were accepted on the board (record 2026-10-13-A); the radio uplink has not been run yet.** Every item marked *Open* below needs a hardware test or a
> decision. When a test closes an item, record the result in
> [21_Test_Records.md](21_Test_Records.md), change the item's status here to *Closed* with the
> date and the measured value, and update the named configuration value if needed.
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
