Tanay7/Benchmarks/docs/img/ui_link_security.png

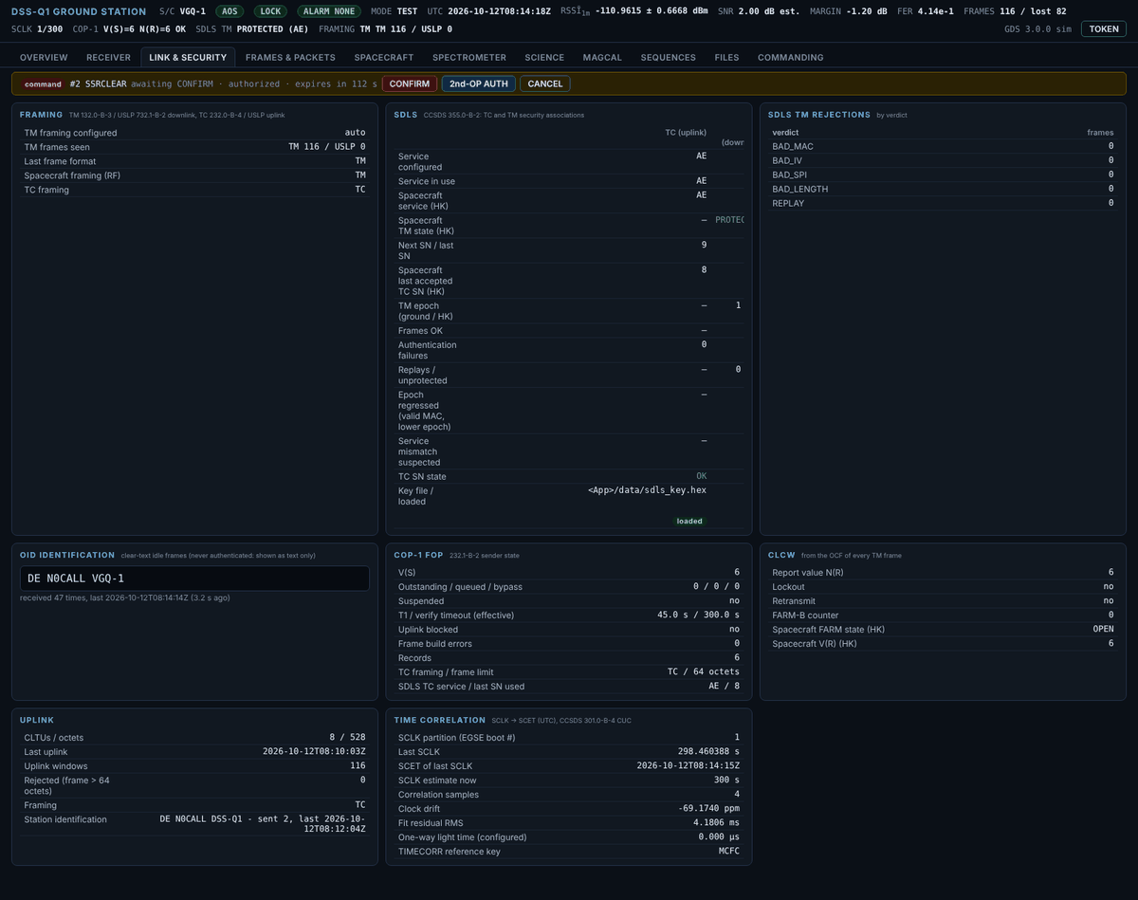
docs/img/ui_link_security.png
