Tanay7/Benchmarks/docs/img/ui_sequences.png

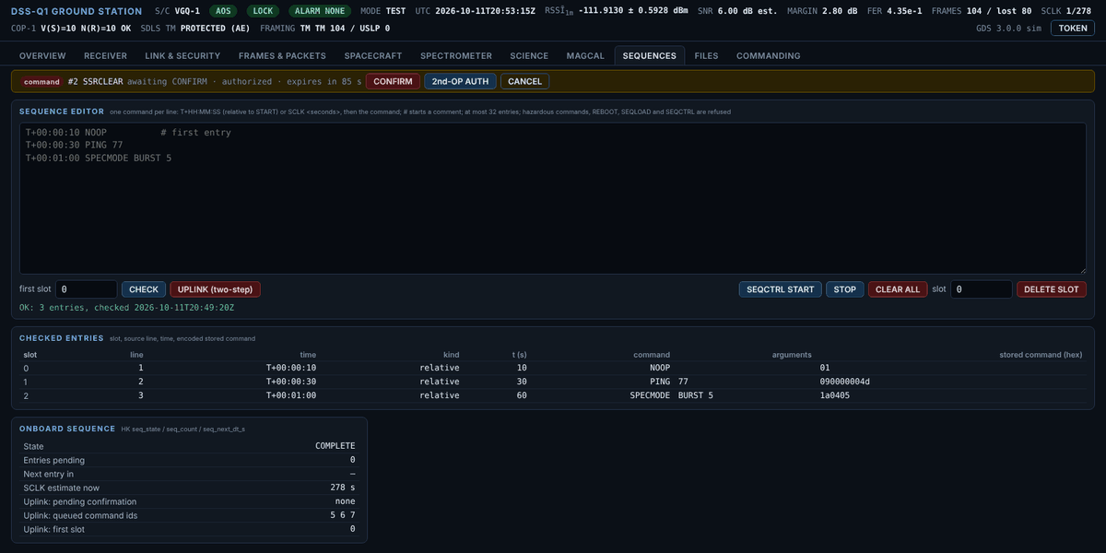
docs/img/ui_sequences.png
