Tanay7/Benchmarks/docs/img/ui_spectrometer_1.png

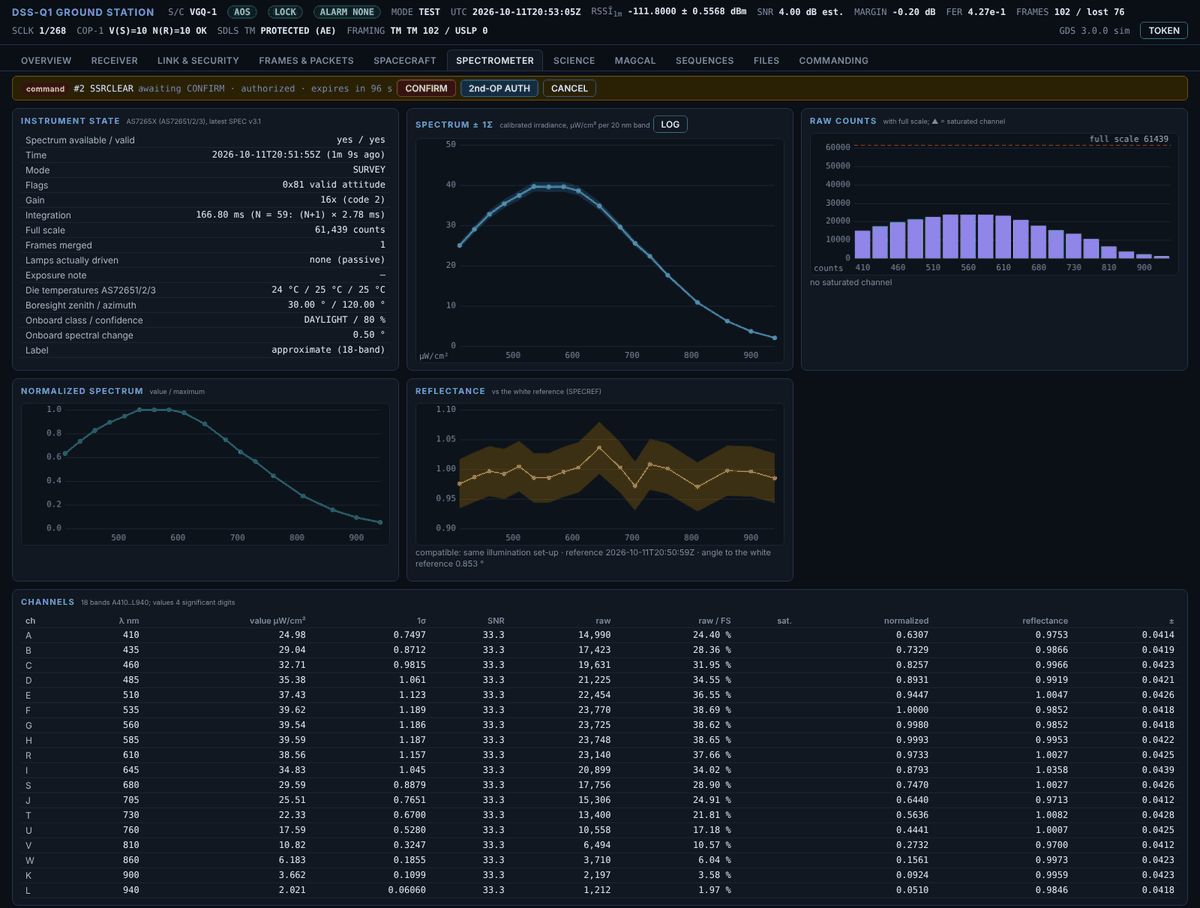
docs/img/ui_spectrometer_1.png
