Tanay7/Benchmarks/docs/img/ui_spectrometer_2.png

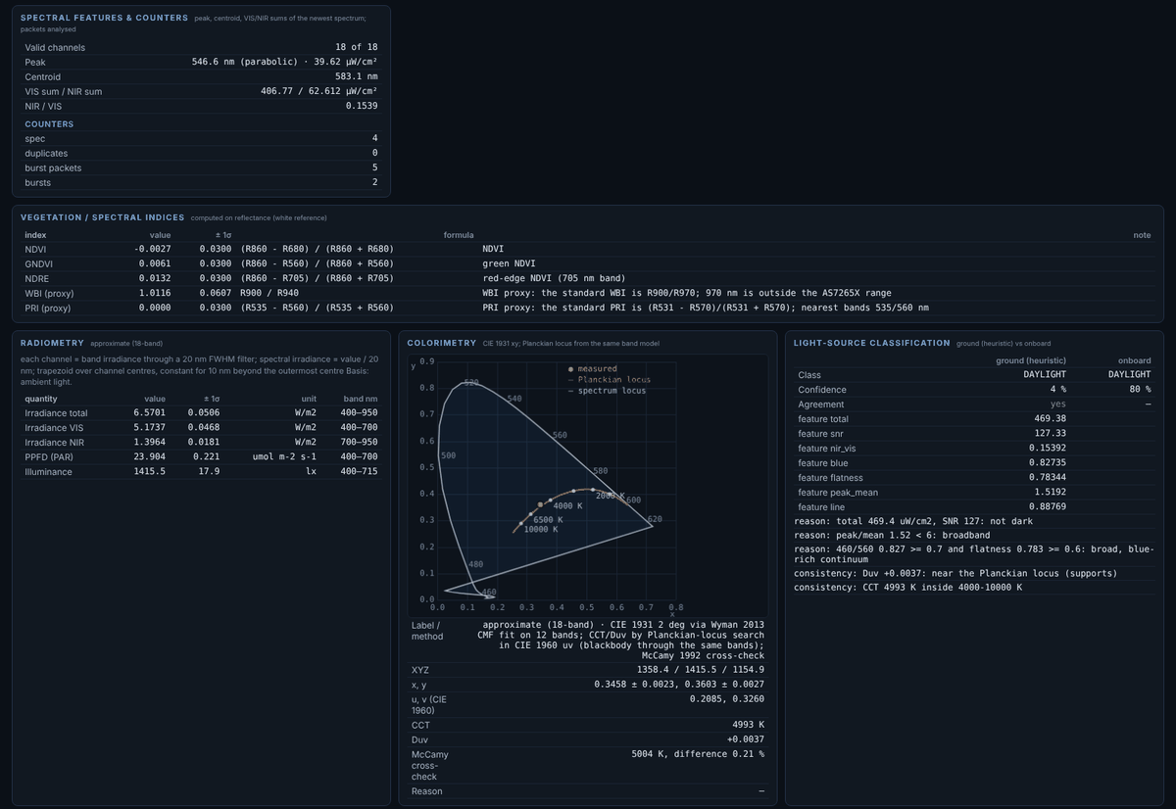
docs/img/ui_spectrometer_2.png
