Tanay7/Benchmarks/spacecraft/vgq1_flight/sketch/src/ccsds/tc.cpp

#include "tc.h"
#include "crc16.h"
#include <string.h>

namespace ccsds {

// ---------------------------------------------------------------------------
// BCH(63,56)
// ---------------------------------------------------------------------------
static uint8_t bch_remainder(const uint8_t info[7]) {
  // Shift-register division by g(x) = x^7 + x^6 + x^2 + 1 (taps 0x45 below x^7).
  uint8_t reg = 0;
  for (int i = 0; i < 7; ++i) {
    for (int b = 7; b >= 0; --b) {
      const uint8_t in = (info[i] >> b) & 1;
      const uint8_t fb = (uint8_t)(in ^ ((reg >> 6) & 1));
      reg = (uint8_t)((reg << 1) & 0x7F);
      if (fb) reg ^= 0x45;
    }
  }
  return reg;  // 7 bits
}

void bch_encode(const uint8_t info[7], uint8_t out[8]) {
  memcpy(out, info, 7);
  out[7] = (uint8_t)(((~bch_remainder(info)) & 0x7F) << 1);  // complemented + filler 0
}

namespace {
// syndrome (7 bits) -> bit position to flip (0..55 info, 56..62 parity), 0xFF none
uint8_t g_syn[128];
bool g_syn_ready = false;

uint8_t syndrome_of(const uint8_t cb[8]) {
  const uint8_t expect = (uint8_t)((~bch_remainder(cb)) & 0x7F);
  return (uint8_t)(expect ^ ((cb[7] >> 1) & 0x7F));
}

void build_syndromes() {
  memset(g_syn, 0xFF, sizeof(g_syn));
  uint8_t zero_info[7] = {0};
  uint8_t cb[8];
  bch_encode(zero_info, cb);
  for (uint8_t p = 0; p < 63; ++p) {
    uint8_t e[8];
    memcpy(e, cb, 8);
    if (p < 56) e[p / 8] ^= (uint8_t)(0x80 >> (p % 8));
    else        e[7] ^= (uint8_t)(0x80 >> (p - 56));   // parity bits occupy bits 7..1
    g_syn[syndrome_of(e)] = p;
  }
  g_syn_ready = true;
}
}  // namespace

size_t cltu_decode(const uint8_t* in, size_t len, uint8_t* out, size_t cap, BchStats& st) {
  if (!g_syn_ready) build_syndromes();
  // Locate the start sequence (exact match; the 16-bit pattern is long enough
  // given the packetised LoRa link).
  size_t i = 0;
  for (; i + 1 < len; ++i)
    if (in[i] == (uint8_t)(kCltuStart >> 8) && in[i + 1] == (uint8_t)kCltuStart) break;
  if (i + 1 >= len) return 0;
  i += 2;

  size_t n = 0;
  while (i + 8 <= len) {
    uint8_t cb[8];
    memcpy(cb, in + i, 8);
    i += 8;
    const uint8_t s = syndrome_of(cb);
    if (s != 0) {
      const uint8_t p = g_syn[s];
      if (p == 0xFF) { ++st.codeblocks_rejected; break; }   // tail or bad block: end
      if (p < 56) cb[p / 8] ^= (uint8_t)(0x80 >> (p % 8));
      ++st.codeblocks_corrected;
    } else {
      ++st.codeblocks_ok;
    }
    if (n + 7 > cap) break;
    memcpy(out + n, cb, 7);
    n += 7;
  }
  return n;
}
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
