Tanay7/Benchmarks/(commit log)

2026-10-09 WIP: CCSDS flight/ground core, UNO Q flight software, ground data system core
    - Flight (UNO Q MCU): CCSDS TM (packets, VC mux, frames, RS(255,223) dual
    basis, randomizer, ASM), TC (CLTU/BCH, TC frames, FARM-1), SDLS HMAC-SHA-256,
    E22 driver, sensor drivers, FDIR, SSR, attitude (TRIAD, pyramid CSS)
    - Ground: Python CCSDS stack with independent RS decoder, frame sync,
    receiver statistics, FOP-1, command parser, archive, GDS engine
    - Host verification harness: flight C++ compiled on PC, cross-checked
    bit-exactly against the Python decoder (18 tests passing)
    Claude-Session: https://claude.ai/code/session_01UcLkaCXa8cfRsZSVDtqiau
2026-10-09 Ground station: GDS engine, receiver stats, web dashboard, simulator, RCU, link manager
    - VENTUNO Q Linux GDS: frame sync, RS decode, VC/packet extraction, decom,
    limits, EWMA anomaly detection, SCLK correlation, FOP-1 with SDLS,
    SQLite/raw archive, UDP interop (YAMCS/OpenC3), Prometheus metrics
    - Detailed RECEIVER web page (RSSI/noise/SNR windows, histograms, live
    link budget, decoder/sync stats, two-way link table, RF survey)
    - VENTUNO Q MCU front panel: OLED pages, CardKB command console with
    confirm / two-person authorisation, annunciators, Radio Control Unit
    - E22 capability use: RF spectrum survey (both ends), coordinated
    air-rate/channel changes with auto-revert, adaptive li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
    [flight.cpp, flight.h]
2026-10-09 Add replay, link-budget and SDLS key tools, systemd unit, front-panel profile
    - dssq.replay: offline decode of archived CADUs through the live decoder chain
    - tools/link_budget.py: FSPL, horizon, Fresnel and Shannon-limit link budget
    - tools/gen_sdls_key.py: generates the shared SDLS key for both ends (git-ignored)
    - ground/requirements.txt and deploy/dssq-gds.service for the VENTUNO Q Linux side
    - sketch.yaml profile for the VENTUNO Q front-panel sketch
    - Remove the remaining references to the retired GIGA R1 front panel
    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
2026-10-09 Apply EBYTE E22-xxxT37S manual v1.5 facts; efficiency upgrades for the STM32U585
    Radio (EBYTE E22-xxxT37S User Manual v1.5, E22-400TBH-02 manual):
    - Air-rate codes 0-2 are all 2.4 kbit/s on the T37S: rate tables, link
    manager floor (code 2) and profiles corrected everywhere
    - Every power code is 37 dBm: link manager no longer issues TXPWR; PA
    thermal FDIR now silences the transmitter for a cool-down period
    - Sensitivity -126 dBm typ at 2.4k (datasheet); faster rates scaled
    - REG1 bit 2 abnormal-status reports (FF FF FF 01..04: under/over-voltage,
    over-temperature) decoded on the spacecraft (FDIR bit 15, EVRs) and by
    the ground frame synchronizer (station radio health events)
    - TBH-02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
    [config.h, e22.cpp, e22.h]
2026-10-09 Payload: Nicla Sense ME, Nicla Sense Env, AS7265X, RM3100; receiver display on the web only
    Instruments (user selection): the MPU-9250, MMC5603, VEML7700, BME690, AS7343,
    TCA9548A mux, INA226, coarse sun sensor and PA thermistor are removed.
    - One Qwiic bus, no mux: Nicla ME 0x2A, Nicla Env 0x21, AS7265X 0x49,
    RM3100 0x20 (outboard) and optional 0x23 (inboard)
    - Nicla Sense ME firmware: two CRC-protected 32-octet pages (motion:
    fusion quaternion + accuracy in mrad, accel, gyro, BMM150; environment:
    BMP390, BME688/BSEC, gas resistance from SENSOR_ID_GAS). Scales from the
    configured BHI260 ranges; magnetometer LSB configurable (verify on site)
    - RM3100 two-phase (start/collect) reads o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
2026-10-09 Dead-code sweep of both ends
    Verified with -Wall -Wextra -Wunused -Wunused-const-variable=2 on every
    firmware translation unit, a header-symbol cross-reference, and vulture.
    Flight: drop E22::read_config, put_u24, randomizer_octet (host test now
    randomizes zeros), the retired CE_NOT_ALLOWED code; the CLTU decoder uses
    the named start-sequence constant. Ground: drop the LinkMetrics class
    (superseded by ReceiverStats), SdlsSender.overhead, CucTime.sclk_string,
    Decommutator.expected_length, PACKETS_BY_NAME, unused tables/attributes,
    E22Serial.request_noise (shared NOISE_QUERY constant instead), the
    simulator's unused RCU AUX hook; cmdparse now uses the tc.py COP-1 control
    builders instead of d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
    [ccsds_types.h, e22.cpp, e22.h]
2026-10-09 Documentation set, dictionary generator, station I/O as an App Lab app
    - docs/00-11: beginner setup guide, system design, link budget and RF
    analysis, hardware integration (UNO Q wiring to E22, RM3100, Nicla
    Sense ME/Env, AS7265X; VENTUNO Q station I/O and CardKBs), space data
    link ICD, generated TM/TC dictionary, displays, operations, verification
    and test plan, regulatory/safety, references, standards roadmap
    - README.md: project overview and repository map
    - tools/gen_dictionary_doc.py: regenerates docs/05 from the code
    - ground/station_io: VENTUNO Q MCU sketch packaged as an App Lab app
    - dashboard: drop an unused variable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
2026-10-09 Hardware docs: verify against Arduino's UNO Q / VENTUNO Q documentation
    Checked the board facts against Arduino's user manuals, datasheets and
    power specifications (docs-content) and the Zephyr board files:
    - VENTUNO Q: Wire1 is the Qwiic connector (I2C3, PA8/PC9), Wire is the
    header SDA/SCL; CardKB #2 goes on Qwiic (was "verify pins").
    - UNO Q power: Arduino asks for a dedicated 5 V / 3 A source on USB-C;
    the spacecraft now feeds the UNO Q 12 V on VIN (JANALOG pin 8, 7-24 V)
    and the 5 V buck only powers the Nicla boards. Spacecraft supply and
    fuse raised to 4 A for the worst-case sum.
    - UNO Q D3 (PB0, radio M1) is not 5 V tolerant: noted next to its
    3.3 V pull-up; header abs. max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
2026-10-10 Host-test registry and FrameSecurity seam for the v3 work
    - tools/host_test: shared helpers (host_test.h) and a HOST_TEST()
    registry so each topic adds its checks in its own test_*.cpp; the
    Makefile now builds every src/ccsds and src/core source automatically.
    - ccsds/frame_security.h: hook through which the TM/USLP framers apply
    SDLS to downlink frames.
    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
2026-10-10 SDLS authenticated encryption, USLP framing, CFDP PDU core
    - ccsds/aes, ccsds/gcm: AES-256 (FIPS-197) and GCM (SP 800-38D) for the
    flight software; SDLS (355.0-B-2) gains AES-256-GCM on the TC uplink
    (SPI 2) and on TM frames through the FrameSecurity hook (SPI 3, null
    SA fallback), keeping the HMAC authentication service byte-exact.
    - ccsds/uslp + tm/tc: USLP (732.1-B-2) TM framing selectable alongside
    TM 132.0-B-3, USLP TC frames parsed automatically; Python mirrors.
    - ccsds/cfdp: CFDP class-1 PDU builder, modular checksum and sender
    (work in progress).
    - Tests: AES/GCM known answers, SDLS AE round trips and tamper/replay
    rejection, USLP flight<->ground bit-exact cross-checks.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
2026-10-11 CFDP class-1 file delivery: flight sender, ground receiver, EGSE sender
    - ccsds/cfdp: CCSDS 727.0-B-5 unacknowledged-mode PDUs (Metadata, File
    Data, EOF), incremental modular checksum, CfdpSender over a generic
    file source, cancel with condition code 15.
    - ground/dssq/ccsds/cfdp.py: PDU codec and class-1 receiver (complete,
    incomplete with missing ranges, checksum failure, cancelled,
    abandoned) writing files under the archive; sender for the simulator.
    - spacecraft python/cfdp_tx.py: stdlib-only EGSE sender sized for the
    Router Bridge inbound buffer.
    - Tests: flight PDUs reassemble bit-exactly on the ground; gaps,
    duplicates, reordering, corruption, cancel and inactivity cases.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
    [cfdp.cpp, cfdp.h, test_cfdp.cpp]
2026-10-11 AS7265X driver, onboard spectral processing, ground spectral analytics
    - drivers/as7265x: own non-blocking implementation of the AS7265x I2C
    virtual-register protocol (timeouts on every poll), every chip feature
    (gain, integration, bank modes incl. one-shot, DATA_RDY/INT, LED_DRV
    electronic shutter, LED_IND, per-device temperature, DEV_SEL health,
    versions, soft-reset recovery, read-only COEF dump) and five
    acquisition modes: survey with AGC, HDR bracketing, lock-in active
    spectroscopy, UV fluorescence, burst capture.
    - fsw/spectral: full scale and saturation, AGC, HDR merge with
    uncertainty, lock-in statistics, log-encoded spectra, heuristic
    light-source classifier, change d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
2026-10-11 Nicla ARU: exact BMP390 pressure in Pa, BMM150 field in 0.1 uT
    Verified against the Bosch BHI260AP datasheet (Table 88, section 13.2.8)
    and the BMM150/BMP390/BME688 datasheets:
    - Barometer output is 24-bit unsigned at 1/128 Pa, so pressure.value()
    is in pascals, not hPa. The ARU sent value()*100 as "hPa x 100", which
    is 100x too large. It now recovers the raw count with the library's
    own factor (Arduino_BHY2 uses 0.0078, not 1/128) and sends exact Pa.
    The pressure flag is set only inside the BMP390 range 300..1250 hPa.
    - Magnetometer-corrected counts scale with the reported dynamic range
    in uT (range/32768). The ARU now sends 0.1 uT, sets page 0 flag b4
    when the range came from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
2026-10-11 Radio abstraction: E22-400T33D default, T37S retained, SX126x option
    Flight (spacecraft/vgq1_flight/sketch/src/drivers):
    - radio.h/.cpp: pure, host-tested radio facts and state machines. E22
    air rates and power tables (T33D 33/30/27/24 dBm, T37S 37 dBm),
    register images, stream parser and TX tracker; LoRa profiles 0..7
    (SF12/31.25 kHz .. SF7/125 kHz), air time, sensitivity (SX1262
    Table 3-8 or computed, labelled by source), FERR_L limits and
    brownout power derating.
    - e22.*: one E22Radio for the T33D (default) and the T37S (kept,
    selectable), behind the vgq::Radio interface.
    - sx126x.*: SPI SX126x driver with per-packet SNR, frequency error,
    CAD before transmit, Rx boosted gain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
2026-10-11 Flight sensor bus on the UNO Q header pins (Wire2 = I2C3, A4/A5)
    All instruments (Nicla Sense ME, AS7265X, RM3100 x1..2) are wired to
    header pins A4 (SDA, PC1) and A5 (SCL, PC0). The core's UNO Q variant
    lists i2cs = <&i2c2>, <&i2c4>, <&i2c3>, so Wire2 is I2C3 on those pins
    and Wire1 (I2C4) is the Qwiic connector, which is no longer used. The
    config also drops the Nicla Sense Env entry and notes the 3.3 V-only
    pull-up rule for A4/A5.
    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
2026-10-11 Host test: compile the SX126x command layer when present
    Adds src/drivers/sx126x_core.cpp/.h to the pure-C++ host build. The
    wildcard is a no-op until the in-house SX126x driver lands.
    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
2026-10-11 AS7265X driver: fix protocol desync, LED overdrive and recovery defects
    Cross-checked against the SparkFun AS7265x library 1.0.5, its examples
    and the ams datasheet v1-04. Twenty findings were confirmed by
    independent verification; these driver-side fixes are applied:
    - Virtual-register resync: the blind resend of an "owed" data byte is
    gone. After a failed write the next list starts with a per-register
    resync byte that has bit 7 clear and passes the write policy. A
    re-sent INTEGRATION value of 128..255 could otherwise be taken as a
    write address, reaching COEF_WRITE (0x55, persistent calibration) or
    the firmware-update registers (0x48-0x4B). A lone data byte with
    bit 7 set is r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
2026-10-11 Ground station runs on the Python standard library only
    The ground data system no longer needs any pip package at run time;
    App Lab's Python image already provides arduino.router_bridge.
    - dssq/ccsds/aes_gcm.py (new): pure-Python AES-256 (FIPS-197) and GCM
    (NIST SP 800-38D), 96-bit IV, 128-bit tag, tag checked with
    hmac.compare_digest before any decryption. A different formulation
    from the flight code (T-tables, Shoup GHASH tables), so agreement is
    a real cross-check. About 0.3 ms per 200-octet frame on a 2.8 GHz x86.
    - sdls.py uses it instead of the cryptography package; API unchanged.
    - radio/e22.py: stdlib termios serial port (raw 8N1, validated E22
    baud rates, select-based tim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
2026-10-11 CCSDS 121.0-B-3 lossless compression (flight encoder, ground decoder)
    Adaptive Entropy Coder with the unit-delay predictor and prediction
    error mapper: zero-block (with ROS), second extension, k-split,
    fundamental sequence and no-compression options, reference samples
    every r blocks, MSB-first packing. Mission parameters n=16 unsigned,
    J=16, r=128; the ground decoder also covers the J/n values of the
    official test data.
    - src/ccsds/rice.*: flight encoder, static buffers only, caller-owned
    output with capacity check, documented worst-case size, no heap.
    - dssq/ccsds/rice.py: decoder plus reference encoder.
    - Verification: the flight encoder reproduces all 56 official CCSDS
    121B2TestData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
2026-10-11 Onboard autonomy: stored sequences, beacon levels, magcal, RM3100 BIST
    New pure, host-tested module src/fsw/autonomy.*:
    - Stored command sequences (Voyager CCS style): 32-entry static table,
    SEQLOAD/SEQCTRL semantics, embedded commands checked with the
    injected live-command validator; hazardous commands, REBOOT and
    nesting refused; one due entry per pass (earliest, lower slot on a
    tie), entries more than 300 s late skipped and reported; START/STOP
    epochs, FDIR stop, overflow-safe u32 SCLK arithmetic.
    - Beacon urgency levels (Deep Space 1 Beacon Monitor): NOMINAL,
    INTERESTING, IMPORTANT, URGENT, latched until ground contact.
    - MAGCAL store: validated hard/soft-iron coefficients (0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
2026-10-11 Ground products: CCSDS TDM, XTCE export, magnetometer calibration, AFC
    - dssq/products.py: CCSDS 503.0-B-2 Cor.1 Tracking Data Message (KVN)
    writer with a validating reader (parses the Blue Book examples),
    and a CCSDS 660.0-B-2 / XTCE 1.2 generator built from dictionary.py
    (validates against the official SpaceSystem 1.2 schema when
    xmlschema is installed). CLI: python -m dssq.products tdm|xtce.
    - dssq/magcal.py: 9-parameter ellipsoid fit in pure Python (Gaussian
    elimination with partial pivoting), hard-iron offset and soft-iron
    matrix scaled to the reference field, coverage and conditioning
    gates, MAGCAL argument encoding.
    - link.py AfcLoop: automatic frequency correction for t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
2026-10-11 CI: host tests, ground tests and the real Arduino build on every push
    One GitHub Actions workflow, pinned to commit hashes:
    - host-tests: flight protocol code built with warnings as errors
    (-Wall -Wextra -Wshadow -Werror), then again under AddressSanitizer
    and UBSan; includes the full official CCSDS 121.0 test data (libaec
    121B2TestData at a pinned commit).
    - ground-tests: the ground suite on Python 3.11 and 3.13.
    - arduino-build: the official arduino:zephyr platform via arduino-cli
    1.5.1, compiling the VENTUNO Q station sketch from its sketch profile.
    The patched RadioLib is bundled first when a profile references it.
    The flight sketch build joins the arduino-build job once integ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
2026-10-11 CI: create the vector folders and install the Arduino Q Boards platform
    - host-tests: the host test writes its cross-check vectors into an
    existing folder; create it first (every check had passed before the
    write).
    - arduino-build: a sketch profile that names arduino:zephyr without a
    version uses the installed platform, as App Lab does, so install
    "Arduino Q Boards" (arduino:zephyr, ArduinoCore-zephyr
    extra/artifacts/zephyr_unoq.json) before compiling.
    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
2026-10-11 RadioLib 7.8.1: bundled patched copy, audited SX126x drivers
    Bundle RadioLib 7.8.1 with each sketch as libraries/RadioLib instead of
    letting the board download it:
    * tools/radiolib.py fetches tag 7.8.1, verifies the tag commit and the
    SHA-256 of the pristine source tree, applies tools/radiolib-7.8.1.patch
    (exact-match hunks) and writes PROVENANCE.txt; "check" re-verifies a
    copy offline. Both sketch.yaml profiles reference "- dir:
    libraries/RadioLib"; the fetched copies are gitignored.
    * The patch adds the VENTUNO Q platform entry (the stock library fails to
    compile there: PinMode / PinStatus conversions) and sets
    RADIOLIB_STATIC_ONLY plus module exclusions in BuildOptUser.h, so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
2026-10-11 Phase B: integrate the v3 flight software and ground data system
    Flight data and protocol layer (WS1): v3 packet layouts (HK 78 octets),
    the 32-opcode command table, a downlink scheduler and TC accept chain in
    the new fsw/datalink module (TC/USLP x NONE/AUTH/AE, replay and bad-MAC
    rejection, relay and EVR gates), VC3 for CFDP, SSR export, and the
    channel-major Rice-compressed SPECBURST block. test_integration.cpp
    writes the integration streams the ground cross-checks.
    Flight executive and drivers (WS2): flight.cpp/.h rebuilt on the WS1
    interfaces and the radio abstraction; config.h moves the sensor bus to
    Wire2 on header pins A4/A5 and adds the SX126x wiring; I2C bus
    recovery, RM3100 self-t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
2026-10-11 Phase B: UNO Q Linux-side EGSE for the v3 flight software
    main.py runs the EGSE on the UNO Q's Linux side: CADU archive, the SCLK
    partition / SDLS TM epoch (a new, persisted boot counter on every MCU
    boot, atomic counter files, refusal and exhaustion handling) and the
    CFDP relay of files to the MCU (cfdp_tx.py). A cfdp_req with a new
    sequence number replaces a stale relay, matching the flight RelayGate,
    which only admits the newly authorised transfer. No requirements.txt:
    the App needs no pip package. app.yaml describes the v3 App.
    test_cfdp.py: 19 new EGSE tests (partition rules, counter files, relay
    replacement, CADU archive).
    Verified in a clean worktree: ground pytest 444 passed on Pyt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
2026-10-11 Snapshot the v3 contract with today's owner decisions and the resume state
    Adds contract sections 32-38: the repository rename, radio model selection
    by a strap pin (no code edits), the Phase C review scale, documentation
    knowledge capture (design decision log), the Tier 1 and Tier 2
    documentation sections, the detailed web UI reference, and the resume
    state for a usage-limit pause. Temporary working copy: Phase D folds it
    into the final documentation and removes it.
    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
2026-10-11 Phase B: radio model strap, RS rescue, CI flight build, annunciator
    E22 model without code edits (contract 33): the E22 build reads a strap
    on header A0 (D14, PA4) at boot, five reads with the internal pull-up,
    1 ms apart; a majority LOW (jumper to GND) selects the E22-400T37S,
    open keeps the build default (E22-400T33D). One binary serves both
    modules: the radio model is now a runtime value, so the power-code
    meaning, the T37S REG1 image (0x24), fault-log decoding, sensitivity and
    the RF packet radio_model follow it; EVR 0x0308 reports it at boot. The
    SX126x option stays a build switch. Ground: [radio] model = "auto" (or
    an absent key) follows the E22 model the spacecraft reports.
    RS rescue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
2026-10-11 Phase B: v3 ground web UI (11 tabs) and the App Lab entry
    web.py: the v3 endpoints on the final GDS snapshot, a Content-Security-
    Policy that allows only the page's single inline script (by SHA-256),
    nosniff / no-store / frame / referrer headers, a constant-time token
    check (every POST refused on a LAN bind without a token), a second-
    operator AUTH secret, JSON-only POSTs with Origin/Host checks, strict
    size and type limits, and the /metrics endpoint.
    dashboard.html: one self-contained file (no CDN, no web font) with 11
    tabs: OVERVIEW, RECEIVER, LINK & SECURITY, FRAMES & PACKETS,
    SPACECRAFT, SPECTROMETER, SCIENCE, MAGCAL, SEQUENCES, FILES and
    COMMANDING. Canvas charts and histograms, receiv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
2026-10-11 Phase C: fix the 64 findings of the adversarial review
    Eighteen read-only reviewers (one lens each) reported findings that one
    or two independent skeptics then tried to refute: 62 confirmed (3
    critical, 25 major, 34 minor), 2 split verdicts handled as test gaps.
    Every fix has a regression test where one is feasible.
    Critical:
    - RouterBridge 0.4.3 runs provide_safe handlers on its own update
    thread (priority 5, 500-byte stack), not in loop(). Both sketches now
    post each RPC to a single-slot mailbox that loop() services on its own
    stack (rpc_mailbox.h; station sketch the same), with bounded waits and
    withdrawal of unserved requests. RPC names and signatures unchanged.
    - EGSE SDLS TM e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
2026-10-11 Ground: receiver data logger (1 Hz rx_stats, CSV export, retention, free-space guard)
    rx_stats table in gds.sqlite, one row per second (RSSI, SNR, noise
    floor, margin, frequency error, 10-min FER, RS corrections, AFC,
    Doppler, frames ok/lost, AOS/LOS). python -m dssq.export and an
    authenticated FILES-tab export write CSV (UTF-8, units in headers,
    ISO-8601 UTC + unix seconds, bounded memory, read-only DB, spreadsheet
    formula guard). Retention by archive_keep_days / archive_max_gb (never
    the current day) and a free-space guard (archive_min_free_mb) that
    pauses raw logging with a WARN and YELLOW alarm and resumes on its
    own. WAL mode so exports never block the station.
    Verified in a clean work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
2026-10-11 Bundle a patched Arduino_RouterBridge 0.4.3 with both sketches
    Owner decision (contract 41). The platform's RouterBridge 0.4.3 runs
    its RPC update thread on a 500-octet stack and executes provide_safe
    handlers on that thread. The measured worst-case chain from the thread
    entry is 920 octets (plus FP exception frame and TLS: 1084), and the
    board has no hardware stack protection.
    tools/arduino_routerbridge-0.4.3.patch (src/bridge.h, documented per
    hunk): (1) bridge thread stack 1536 octets, allocated once at begin()
    from the system heap (42 % margin over the measured worst case); (2)
    update() never executes "__safe__" methods: it peeks the head request
    under the same mutex and leaves safe met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
2026-10-12 Phase D: two App Lab Apps, offline packaging, final fixes, full documentation
    Repository layout
    - The spacecraft and the ground station are now one Arduino App Lab App each:
    vgq1-spacecraft/ (UNO Q: flight sketch + EGSE) and dssq-groundstation/ (VENTUNO Q:
    ground data system + station I/O sketch + optional host/systemd mode). Ground tests
    moved to tests/, PC tool settings to pyproject.toml and requirements-dev.txt.
    - tools/package_apps.py builds and verifies the two reproducible App Lab zips (bundled
    patched RadioLib 7.8.1 and Arduino_RouterBridge 0.4.3; refuses any key material).
    Fixes and features after the Phase C review
    - Flight: hardware watchdog (IWDG, 40 s); TX duty meter ove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
2026-10-12 Rebuild the two App Lab packages from f6cd7f5
    dist/vgq1-spacecraft-unoq.zip (5 368 743 octets, 256 files) and
    dist/dssq-groundstation-ventunoq.zip (5 509 622 octets, 238 files), built with
    tools/package_apps.py from commit f6cd7f5 and checked with
    tools/package_apps.py --verify --build: layout, attributes, bundled patched
    libraries (RadioLib 7.8.1, Arduino_RouterBridge 0.4.3), no key material, and a
    real arduino:zephyr compile of each unpacked sketch (flight 233 264 B flash /
    128 492 B RAM, station 100 828 B / 40 716 B). SHA-256 in dist/SHA256SUMS.
    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
2026-10-12 UNO Q flight App: build, load and start on App Lab releases before 1.0.0
    The first import of the flight App on a real UNO Q stopped at the link:
    App Lab still built with arduino:zephyr up to 0.90.0 (Zephyr SDK 0.16.8,
    GCC 12.2), which links the sketch with newlib-nano's libm:
    libm_nano.a(lib_a-wf_exp.o): in function `expf':
    wf_exp.c:(.text.expf+0x34): undefined reference to `__errno'
    (also log10f, powf)
    Reproduced with arduino:zephyr 0.90.0 built from source (same addresses),
    then fixed:
    * src/libc_compat.cpp: a weak __errno for the errno-setting libm wrappers.
    Nothing reads errno; on 1.0.0 (picolibc libm) it is unreferenced and
    dropped from the build.
    * src/fsw/rpc_mailbox.h: t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
2026-10-12 AS7265X on the UNO Q Qwiic socket or on A4/A5, auto-detected
    On the owner's request (revision of D-13) the AS7265X may be plugged into
    the UNO Q Qwiic socket (Wire1 = I2C4, config.h QWIIC_WIRE) instead of the
    header pins A4/A5. Nothing else uses a Qwiic connector.
    * As7265x::begin(bus, int_pin, alt_bus): every probe (boot wait, absent
    re-probe, fault re-probe) tries the bus in use, then the other one, and
    the driver stays on the bus that answered (on_alt_bus()). A4/A5 is tried
    first, so the existing wiring behaves as before. The boot wait is now
    bounded by time (kSpecBootWaitMs plus the last probe) instead of a probe
    count, so a slow probe on an empty bus cannot stretch it.
    * Flig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
2026-10-12 Flight software on 64-octet Serial rings (arduino:zephyr 0.90.0)
    On the UNO Q with stable App Lab (core pinned below 1.0.0) the EGSE's
    calls were accepted but sc_status never arrived: core 0.90.0 builds the
    sketch with CONFIG_ARDUINO_API_SERIAL_BUFFER_SIZE 64, while the software
    was sized for the 1024-octet rings of core 1.0.0 (D-66).
    * drivers/byte_fifo.h: lock-free single-producer / single-consumer FIFO
    (GCC __atomic acquire/release).
    * drivers/uart_pump.*: only when the rings are smaller than 1024 octets
    (config.h VGQ_SMALL_SERIAL_RINGS) a thread at priority 6, every 1 ms,
    moves the E22 port's RX ring into a 1024-octet FIFO and tops its TX
    ring up from a 512-octet FIFO. A frame s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
2026-10-12 Empty A4/A5 bus is not a stuck bus (D-67); record the first bench run
    The owner's first bench run of the flight App (UNO Q, E22-400T33D,
    AS7265X on Qwiic, nothing on A4/A5, App Lab core 0.90.0) worked: status
    every 10 s, radio configuration read back (FDIR 0x0000), 19 frames sent
    at 25 % duty, 19 CADU copies archived by the EGSE, no reset with the
    radio on the board's 5 V. It also logged EVR 0x060A "I2C bus clear: SDA
    or SCL still low after 9 clocks" at every re-probe of the absent
    instruments: with no pull-up an empty bus reads low.
    * drivers/i2c_bus.cpp: the bus clear releases SDA/SCL with INPUT_PULLUP
    (the MCU's weak pull-up, about 40 kOhm) instead of INPUT. An empty bus
    reads high;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
2026-10-12 Record the second bench run: D-67 confirmed on the board
    The owner re-imported the App from the zip of f71475e: no EVR 0x060A
    (the first run logged it at the first re-probe, about 30 s after boot;
    this run reached SCLK 55 s without it) and 7 start-up EVRs not
    forwarded instead of 8. Everything else as in the first run; the noise
    reading was -57 to -58 dBm (first run -70 to -75), cause not recorded.
    docs/21 record 2026-10-12-A (second run), docs/12 D-67 evidence,
    CHANGELOG. Docs tests pass (11).
    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
2026-10-13 Ground radio on the E15-USB-T2 (rcu = false default); record the first downlink
    The ground station on the owner's VENTUNO Q received and decoded the
    spacecraft's downlink on the bench (record 2026-10-13-A). Its E22 sits
    on EBYTE's E15-USB-T2 USB test board, which the owner keeps.
    * [gds] rcu defaults to false (dssq/config.py, config/station.toml;
    D-68): the adapter's jumper caps hold M0/M1. With true and no Radio
    Control Unit wired every start reported "did not answer the
    configuration read". The RCU stays the option (rcu = true).
    * TDM warning: it named the station clock for any rejected record; an
    overdriven E22 (RSSI -256 dBm) with a correct clock read as a clock
    fault. It now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
2026-10-13 Docs: hardline commanding, dashboard checks, first spectrum at the ground
    Record 2026-10-13-A gains observations 9-12: the spacecraft's noise
    reading with the attenuator fitted (-91 to -93 dBm), the first hardline
    command (PKTRATE SPEC 30: accepted, SPEC packets on VC1), the first
    spectrum decoded at the ground, and the dashboard that stopped updating
    when App Lab was switched to the other board. Open: four AS72653
    channels (B435, C460, E510, F535) without data.
    * docs/07 2.6: a concrete hardline line without angle brackets (the
    shell takes < > as redirections) and the expected console lines.
    * docs/14: rows for the frozen dashboard (curl .../api/state, Run at
    startup on both boards), t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
2026-10-13 Spectrometer: judge saturation on every channel read (D-69)
    On the owner's board, with a phone torch on the AS7265X and AGC on,
    channels at full scale arrived with an unusable calibrated value and
    were dropped as invalid. Saturation was judged on the valid channels
    only, so the AGC never saw them and held 64x / 711.68 ms: B435, C460,
    E510, F535 and later R610 showed "-" in every column with "no
    saturated channel". At a fixed 1x gain all 18 channels were valid
    (record 2026-10-13-A, observations 11 and 13).
    * fsw/spectral.cpp/.h: spec_frame_saturation() = the saturation mask
    over every channel of the devices read, valid or not.
    * drivers/as7265x.cpp frame_done(): uses it, so the AGC steps d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
2026-10-13 Show received power at the readings' resolution (D-70)
    On the owner's request: "-39.2000 +/- 0.3266 dBm" read as a precision
    the E22 does not have. Its RSSI and noise register are whole dB
    (dBm = -(256 - value)); the SX126x RSSI comes in 0.5 dB steps.
    * dashboard.html: fres() rounds measured received power and what is
    derived from it (RSSI, noise floor, SNR est., margin est., signal
    power est., N0, C/N0, Eb/N0, measured path loss) to the readings'
    resolution: whole dB with the E22, 0.5 dB (RSSI) / 0.1 dB (the rest)
    with the SX126x; no "+/- SEM" next to these means. The header and
    the OVERVIEW tiles show the newest frame's RSSI and SNR est. instead
    of 1-minute means; the window s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
2026-10-13 Cite the E22 manual for the RSSI step; hardline commanding status
    The E22-400T33D manual v1.05 supplied by the owner was checked for the RSSI
    resolution used by D-70: REG1 bit 5 (noise register 0x00, last-packet register
    0x01) and REG3 bit 7 (the appended RSSI octet) give one whole octet,
    dBm = -(256 - octet), with no finer step, no accuracy figure and no
    receiver-gain setting (the module has a fixed built-in PA+LNA). docs/10 and
    docs/13 now cite those registers.
    The status lines in README, CHANGELOG, FAQ, Project_Summary and docs/20 said
    commanding had not been run on hardware; hardline commands were accepted on
    the board (record 2026-10-13-A). They now say so, and that the radio uplink
    ha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
2026-10-13 Close two docs gaps: SEM column on power rows, six new open items
    RECEIVER statistics: the "± SEM" column showed the received-power rows'
    SEM rounded to the readings' resolution (with the E22 nearly always "0"),
    against the D-70 rule in docs/13 that these means carry no SEM. It now
    shows "—" on the RSSI, noise floor and SNR est. rows; the snapshot keeps
    the value. docs/13's statistics example says so. Ground zip rebuilt.
    docs/20 records the open items found in the E22-400T33D manual v1.05 and
    JPL's Deep Space Communications (Taylor, 2014): V-71 over-the-air
    configuration (CF CF), V-72 a module restart reloads its saved settings
    while the flight writes volatile ones (and the flight would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
2026-10-17 Ground station on the Arduino UNO Q 4 GB behind a USB-C hub (D-71, D-72, D-78, D-79, D-80)
    Station sketch (dssq-groundstation/sketch):
    - FQBN arduino:zephyr:unoq; pin plan H (D-72): RCU M0 D2, M1 D3, AUX D7 (the
    spacecraft's E22 pins), lamps AOS D4 / ALARM D5 / UPLINK D6, buzzer A1, A0 free;
    SX126x NRST moved from A1 (now the buzzer) to A4; CardKB on Wire = I2C2 (D20/D21).
    - k_sched_current_thread_query() instead of k_current_get(): loads on 0.90.0.
    - SX126x airtime: 32-bit bandwidth conversion (the float -> uint64 conversion needs
    __aeabi_f2ulz, which the 0.90.0 link does not provide).
    - Hello reports the result and age of the last rcu_mode() call (D-78) instead of a
    constant 1; fir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
